bigtreetech/KNOMI/KNOMI_GIF/gif_probing/gif_probing.gif

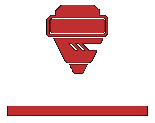
KNOMI_GIF/gif_probing/gif_probing.gif
