bigtreetech/KNOMI/Customized Printed Parts/Mounting Plate & StealthBurner Main Body for KNOMI.STL

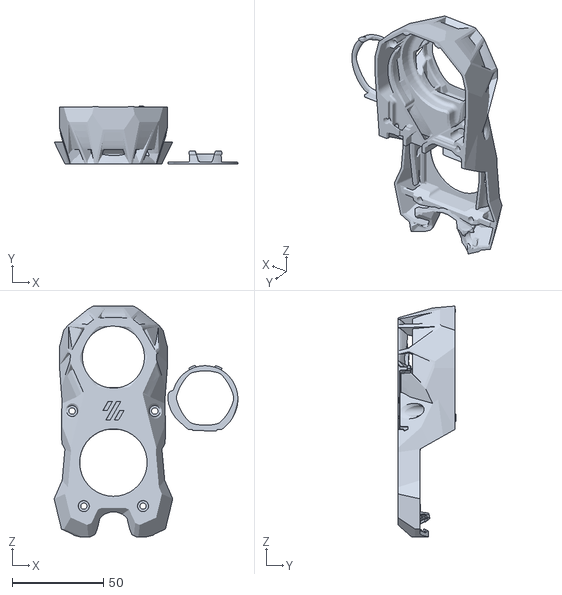
[picture p4: CAD file, 2023-04-26]
Customized Printed Parts/Mounting Plate & StealthBurner Main Body for KNOMI.STL
100.9 x 31.8 x 126.8
