bigtreetech/KNOMI/KNOMI1/Customized Printed Parts/StealthBurner Main Body for KNOMI.STL

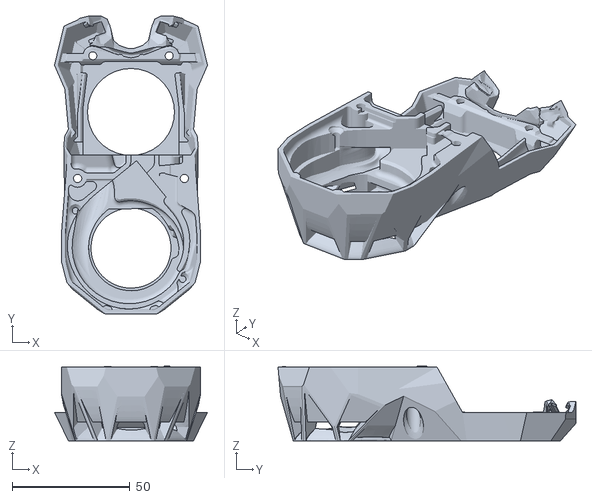
[picture p5: CAD file, 2023-06-05]
KNOMI1/Customized Printed Parts/StealthBurner Main Body for KNOMI.STL
65.1 x 126.8 x 31.8
