bigtreetech/KNOMI/KNOMI1/Customized Printed Parts/StealthBurner Mounting Plate for KNOMI.STL

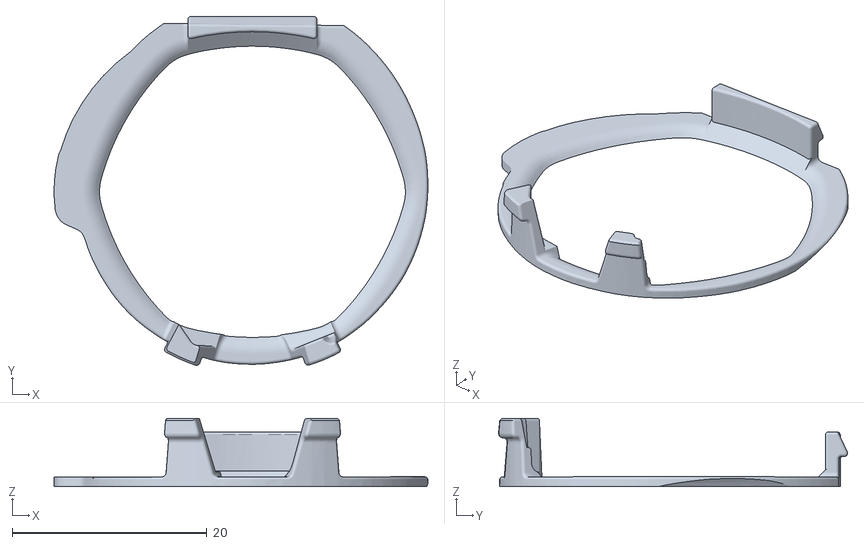
[picture p6: CAD file, 2023-06-05]
KNOMI1/Customized Printed Parts/StealthBurner Mounting Plate for KNOMI.STL
38.4 x 35.8 x 7.00
