bigtreetech/KNOMI/KNOMI2/CAD/KNOMI 2 Mounting Plate固定卡环V2.0.STEP

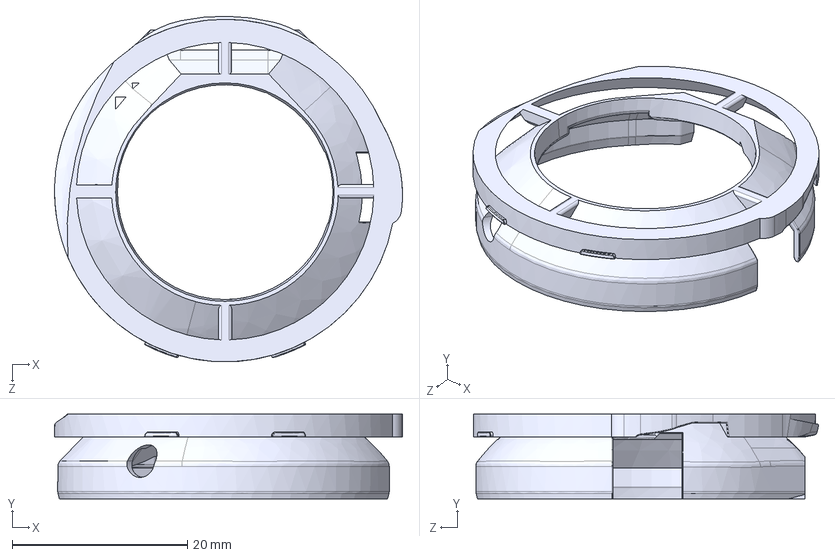
[picture p7: CAD file, 2024-03-30]
KNOMI2/CAD/KNOMI 2 Mounting Plate固定卡环V2.0.STEP
39.7 x 9.63 x 39.4 mm
