bigtreetech/KNOMI/KNOMI2/STL/KNOMI 2 Mounting Plate固定卡环.stl

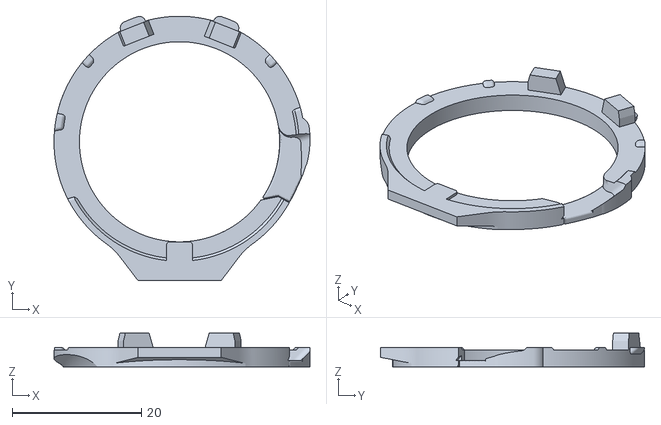
[picture p8: CAD file, 2023-11-15, an earlier design]
KNOMI2/STL/KNOMI 2 Mounting Plate固定卡环.stl
39.7 x 41.0 x 5.20
