bigtreetech/KNOMI/(list of files, cad)

Other CAD files:
KNOMI2/STL/KNOMI 2 Mounting Plate固定卡环V2.0.stl
