bigtreetech/KNOMI/KNOMI_GIF/gif_print/gif_print.gif

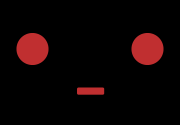
KNOMI_GIF/gif_print/gif_print.gif
