bigtreetech/KNOMI/(threads)

Thread 1 (2023-05-03):

Konomi PC duct section too thin.

Dr-Info, 2023-05-03:
Part has a section with a lack of material for printing with voron print specs, .2mm layer height. I checked the STL and even exported the STL from the CAD, both have the same issue.

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

bigtreetech, 2023-05-05:
Fixed in https://github.com/bigtreetech/KNOMI/commit/eafe51ef290f9e47f16155080b72e3c8a89418d7

Closed 2023-05-05.

Thread 2 (2023-05-07):

Macros on PDF do not format Correctly and getting `Macro G28 called recursively` homing errors from provided macros

BoothyBoothy, 2023-05-07:
Hi BTT
1. Copying the PDF macro content directly from the PDF does not work because all formatting content is lost and Klipper fails to boot due to parsing errors. The gcode lines need indenting to stop the parsing issue.
2. After including the Knomi Macros Print_Start fails with a repeated homing error stating `Macro G28 called recursively` (3 times).

Please advise and thanks Boothy

hdragoon, 2023-05-08:
You may did something wrong, as I did the same as instruction and no problem at all.

BoothyBoothy, 2023-05-08:
Thanks for the response. Hmmm, are you using a Klicky Probe or Tap? May be the external Klicky variable causing the issues? I doubt if my install will last long anyway, the PFC is less for it, great fun but not at the cost of print quality IMHO.

BoothyBoothy, 2023-05-08:
Further to my last comment. I use a Klicky Probe on my V2. If  I exclude the Klicky Variables.cfg the BTT homing macro works without errors and I get a House symbol on the Knomi display whilst homing, not tried anything else yet. The BTT macro therefore seems to work but does not allow for any external homing Macro reference like Klicky external Macros. I will need to consider what is the most tidy way forward with this and the Klicky. Thanks Boothy

dirkgo, 2023-05-09:
Same here. Also with Klicky Probe. Will figure out later today, how to fix it.

Surion79, 2023-05-17:
@BoothyBoothy I created a Pull Request to fix the G28 issue by using a dedicated `_KNOMI_STATUS` macro

Cyondil, 2023-05-18:
> @BoothyBoothy I created a Pull Request to fix the G28 issue by using a dedicated `_KNOMI_STATUS` macro

I have the Knomi and tested your PR and it doesn't seem to work at all.  If I use the lines above pointing to BED_MESH_CALIBRATE, the Knomi accurately shows levelling.  When I substitute in _KNOMI_STATUS, it doesn't work.  So seems like the logic is looking for the combination for the variable of the probing variable change and the BED_MESH_CALIBRATE combination.

Cyondil, 2023-05-18:
Had a whole thing typed up with a fix for homing this, but realized that while testing, my individual axis homing broke, so I am not confident enough to offer it as a fix.

Bazeone, 2023-06-06:
The changes worked for me.

sgermain06, 2023-07-02:
Yeah, I took a similar approach and added a `CUSTOM_HOMING` macro that the code is listening for, but it doesn't feel right. There has to be a better way to do this.

PeterGarthAmos, 2023-07-13:
Hi, all, I'm not that clued up with the code, please could you explain what you did exactly if you don't mind. (dumb it down) I have the same issue and have not been able to resolve it. I have klicky. the knomi macro causes Macro G28 called recursively.

3DMat, 2023-07-19:
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

hello sorry can you put a screen of the macro for homing if it's possible I'm trying the thousand recommended methods including using the _knomi_status updating the knomi with vcore and the bed mesh doesn't even work (only works using the one posted here)
A thousand thanks

silentstorm21, 2023-10-01:
i'm having this issue now

BoothyBoothy, 2023-10-01:
I found this to work well on my Minion Bed Slinger with Klicky.
https://github.com/bigtreetech/KNOMI/pull/5
The only thing that does not appear to work is the print finished macro? I have no problems with anything else.
Best Boothy

nephilim667, 2023-10-26:
Hello, i have integrated a knomi on my Creality K1. As i have issues to modify Knomi firmware, i have found solution to make it works with sandard firmware.
You can found details of macros modifications here :
https://github.com/D3vil-Design/K1-Hardware-Mods/issues/4#issue-1962019105

Thread 3 (2023-05-10):

Newest STL does not include the mounting plate

Cyondil, 2023-05-10:
The file only contains the Stealthburner cover, no mounting plate.

neriux912, 2023-05-10:
It is in step file, but not in stl

neriux912, 2023-05-10:
> The file only contains the Stealthburner cover, no mounting plate.

https://github.com/neriux912/KNOMI/blob/master/Customized%20Printed%20Parts/Mounting%20Plate.stl

Cyondil, 2023-05-15:
Looks like it was added after I looked.

Closed 2023-05-15.

Thread 4 (2023-05-13):

E3d Volcano?

el-quique, 2023-05-13:
Hello. Any chance for E3d Volcano? Thank you so much

hdragoon, 2023-05-14:
What does this have to do with e3d volcano hotend?

el-quique, 2023-05-15:
Hello. Thanks for answering. It is for use in an Artillery X1 printer. This printer uses the E3d Volcano, as its X axis uses a 2060 profile it needs the E3d volcano. There are some Stealthburner mods on thingiverse, but they have some bugs.

el-quique, 2023-05-16:
New change in the assembly design that I am designing, would give me the possibility of using a standard E3d v6. Maybe use a high flow nozzle. Thank you so much

Closed 2023-05-17.

Thread 6 (2023-05-17):

Animations have low fps after uploading Firmware

oMTEo, 2023-05-17:
As the title says after I uploaded compiled code via VSCode to a Knomi the animated Voronlogo/Emotes have very bad low fps. Maybe there are some settings missing in the firmware.

oMTEo, 2023-05-17:
It works now, Ive forgot to use this platform package -> https://github.com/z1996xm/arduino-esp32

Surion79, 2023-05-17:
@oMTEo can you please close this issue since it is no longer an issue? Thanks :)

oMTEo, 2023-05-17:
Done :)

Closed 2023-05-17.

Thread 7 (2023-05-18):

Homing certain axis homes all

neriux912, 2023-05-18:
Homing only one axis, homes all of them. Not work either clicking in Webui or issuing command in console

Surion79, 2023-05-20:
I hope the PR I created comes through. Then this is no longer an issue

neriux912, 2023-05-20:
> I hope the PR I created comes through. Then this is no longer an issue

is there any clear instructions online, how to recompile firmware?

SrgntBallistic, 2023-05-29:
> how to recompile firmware?

https://bigtreetech.github.io/docs/KNOMI.html#customize-ui

Outlined here. Setup VS Code with platformIO. Connect via USB-C -> verify/compile and upload

Closed 2023-05-29.

Thread 8 (2023-05-20):

Mounting plate?

appleimperio, 2023-05-20:
Where is the sty for the mounting plate?

neriux912, 2023-05-20:
> Where is the sty for the mounting plate?

https://github.com/neriux912/KNOMI/blob/master/Customized%20Printed%20Parts/Mounting%20Plate.stl

appleimperio, 2023-05-20:
Is the same? why is not in the Bigtreetech GitHub?

neriux912, 2023-05-20:
> Is the same? why is not in the Bigtreetech GitHub?

it's pulled out from step file

appleimperio, 2023-05-20:
ok Thanks

Closed 2023-05-20.

Thread 9 (2023-05-21):

Mounting plate missing from STL.

grimlokason, 2023-05-21:
Hello,

The mounting plate is not anymore in the STL here :

https://github.com/bigtreetech/KNOMI/blob/master/Customized%20Printed%20Parts/Mounting%20Plate%20%26%20StealthBurner%20Main%20Body%20for%20KNOMI.STL

zcohenld, 2023-05-22:
They just updated it with the mounting plate, but be aware, they uploaded the two parts as one file and most importantly the mounting plate is not flat on the build plate. So break it into two parts and use the place on face tool in your slicer to lay the plate flat.

thisiskeithb, 2023-05-23:
Here's a zip with the KNOMI StealthBurner & separated mounting plate properly aligned: [Mounting Plate & StealthBurner Main Body for KNOMI.STL.zip](https://github.com/bigtreetech/KNOMI/files/11543902/Mounting.Plate.StealthBurner.Main.Body.for.KNOMI.STL.zip)

chromusphil, 2023-05-31:
The new version was rushed and the plate isn't sitting flat, please provide separate STLs and or FIX the plate so its laying flat on the bed.

grimlokason, 2023-06-04:
@bigtreetech is it possible to accept the pull request ?

Thank you.

Closed 2023-06-06.

Thread 11 (2023-05-31):

Failed to connect to ESP32: No serial data received

Guilouz, 2023-05-31:
It's impossible for me to flash Knomi. I have tested on MacOS and Windows, same issue.

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

Serial Console detect Knomi but impossible to flash it :

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

oMTEo, 2023-05-31:
To upload Firmware to Knomi follow these steps :
-Remove Knomi from USB-Port.
-Push Upload in VSCode and wait till "Connecting....."
-Hold down the Boot-Button on Knomi, plug it back to the USB-Port and release Boot-Button.

Closed 2023-05-31.

Thread 14 (2023-06-06):

Printing percentages not correct

Nelus82, 2023-06-06:
Mainsail and klipperscreen gives a lower percentage of the print than KNOMI.

chromusphil, 2023-08-05:
I’ve experienced this however I did notice that the % matched that displayed in the 12864 screen on my v2.4 so I’m assuming the completeness used by Mainsail/Klipperscreen is calculated differently to the Knomi/12864

chromusphil, 2023-08-06:
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
Further to my reply above

Mcrcheli, 2023-08-31:
Seems to calculate the percentage from the time you press print. As you get into the print the percentage converge and I have seen the numbers match in the 75-80 range.

nephilim667, 2023-10-26:
Hello, i hvae found something relative to this.
Knomi use the Display_Status Api function of Klipper.
As you can see, Display status use value from M73 if GCode containt it :
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

As i have the same issue, i have tried to disable 'Support remaining time' is prusaslicer to avoid emmiting M73 in GCode.
Seem to work. Now Knomi show the same value as i have on my K1 Screen and on Fluidd

Thread 15 (2023-06-29):

KNOMI screen turns off

aee74, 2023-06-29:
Hi, My KNOMI screen just turns off. Sometimes it won't even startup (You can see it's powerd because screen lights up) and other times it starts and half way a print it turns blank.  I tried using different voltages to power the KNOMI everytime the same thing.  Any suggestions?

fsedarkalex, 2025-07-31:
OH! I answered it myself... It does not boot when the camera is not connected

Thread 16 (2023-07-02):

Is there a way for Knomi to show temp by Tool?

TheSin-, 2023-07-02:
I'd like to add a knot to each of my tools and show the temp of the tool it's attached to, is there a way to accomplish this easily?  To T0 will show the temp for T0 and T1 will show the temp for T1 etc etc

M4dMike, 2023-08-10:
Sounds like a cool idea :)

This would require costume code on each Knomi, but can definitely be achieved.

Have a look at line 1007 to 1015 in [main.cpp](https://github.com/bigtreetech/KNOMI/blob/master/Firmware/src/main.cpp)

    String nameStr3 = doc["temperature"]["tool0"]["actual"].as<String>();
    String nameStr4 = doc["temperature"]["tool0"]["target"].as<String>();
    String nameStr5 = doc["state"]["flags"]["printing"].as<String>();
    String nameStr6 = doc["state"]["flags"]["paused"].as<String>();

    bedtemp_actual = (uint16_t)((doc["temperature"]["bed"]["actual"].as<double>())*100);
    bedtemp_target = (uint16_t)((doc["temperature"]["bed"]["target"].as<double>())*100);
    tooltemp_actual = (uint16_t)((doc["temperature"]["tool0"]["actual"].as<double>())*100);
    tooltemp_target = (uint16_t)((doc["temperature"]["tool0"]["target"].as<double>())*100);`

As you can see, its referencing temps for `tool0` -> change that too `tool1` and build + flash it to your second KNOMI

TheSin-, 2023-08-10:
excellent!  I'll order up an other one to see if I can figure it out, this will be great if I can get it running!

TheSin-, 2023-08-10:
Do you know of an example to make it a configuration option on startup, like the screen used for the wifi setup?  That way they can all have one firmware that I can just select the tool id on?

Trying to figure out the codebase for configuration options.

M4dMike, 2023-08-10:
Exactly, adding a 4th input field and storing this information makes it dynamic and would probably help to get this change back into mainline. Awesome!

TheSin-, 2023-08-11:
Into the testing phase now!  Thanks again for leading me into the right direction, I'm going to make a PR once I know 100% it's working and saving.

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

M4dMike, 2023-08-11:
Awesome 😀
Happy to help, knomi has a lot of unused potential 😉

mcbeenb, 2023-11-20:
Awesome work guys!!

Thread 18 (2023-08-01):

2 KNOMI's will not power on by USB-C connection to computer or show up in device list

sprior, 2023-08-01:
I've got 2 KNOMI's which show no signs of power when connected via USB-C to either of two Win 11 laptops (and don't know up as ports in device manager, but do power up when connected via USB-C wall wart.  The problem is that I'm looking to customize their firmware and see no way to do that.  I have other ESP32 devices with power up and flash just fine from my laptop.

I've otherwise got a VS Code dev environment set up just fine for ESP32 devices on this laptop so I'm pretty stumped why the KNOMI's aren't working.  Any ideas?

M4dMike, 2023-08-08:
Had the same issue, USB-A to USB-C works for me, Knomi is showing up in device manager as "USB-SERIAL CH340 (COM3)"

Did you manage to get to a working state? I am struggling with flashing, as uploading the firmware fails...

> A fatal error occurred: Failed to connect to ESP32: No serial data received.

Malygros, 2023-08-10:
> I was using a USB-C to USB-C cable to plug them into my computer. By any chance is a USB-A (computer) to USB-C (KNOMI) cable required to make it work?

Did you mange do get it work? Got the same error. Even with USB-A to USB-C.
USB-SERIAL CH340 (COM4) is recognized in the device Manager.

sprior, 2023-08-10:
It's been working for me with a USB-C to USB-A cable, though the requirement to use one isn't documented anywhere that I've seen.  I also have to hold the boot button before plugging it in, then it's recognized by the flash utility in PlatformIO.

Fragmon, 2023-08-10:
Is this possible that knomi make a Mistake with tracing? They add a 10k on 3.3V not gnd
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

M4dMike, 2023-08-10:
Nope, it's correct and it works fine after all.
If you want to set it into boot mode, disconnect it from power, press the button an plug it in while the button is pressed

sprior, 2023-08-10:
@M4dMike Flash mode only works with a USB-A to USB-C cable for me when connecting to my laptop.  If I use a USB-C to USB-C cable the KNOMI doesn't get power at all when in boot mode or not.  That same USB-C to USB-C cable works with a USB-C power supply.

M4dMike, 2023-08-10:
Same for me.

Fragmon, 2023-08-10:
> @Fragmon Nope, it's correct and it works fine after all. If you want to set it into boot mode, disconnect it from power, press the button an plug it in while the button is pressed

I know this:) but it dont change the Mode. It's always in serial.

sprior, 2023-08-10:
@M4dMike I am not at all an expert on this, but I think I've heard that USB-C devices use resistors to signal their need for power or ability to provide it.  So I thought @Fragmon's comment about resistors not being correct might be related to power delivery and not the ability to enter boot mode.  It could also explain why a USB-A to USB-C cable would work and a USB-C to USB-C does not.

Ybalrid, 2023-09-10:
all I know is that the modem control signals from the serial are not able to reset the device from the USB port. You need to press the boot button to upload new firmware, and once new firmware is uploaded, you need to disconnect and reconnect the device for it to startup again.

Thread 19 (2023-08-07):

Failed to connect to ESP32: No serial data received.

ThomasDennisSp, 2023-08-07:
I tryed the methode that the other person had and others tryed but they had no effect i cant get vs to flash firmware to my knomi it gets detected and everything by vs but the flashing will not work

M4dMike, 2023-08-08:
Get the exact same error.

>Configuring upload protocol...
AVAILABLE: cmsis-dap, esp-bridge, esp-prog, espota, esptool, iot-bus-jtag, jlink, minimodule, olimex-arm-usb-ocd, olimex-arm-usb-ocd-h, olimex-arm-usb-tiny-h, olimex-jtag-tiny, tumpa
CURRENT: upload_protocol = esptool
Looking for upload port...
Auto-detected: COM3
Uploading .pio\build\esp32dev\firmware.bin
esptool.py v4.5.1
Serial port COM3
Connecting......................................
> A fatal error occurred: Failed to connect to ESP32: No serial data received.
For troubleshooting steps visit: https://docs.espressif.com/projects/esptool/en/latest/troubleshooting.html

COM3 is detected as USB-Serial CH340

M4dMike, 2023-08-08:
After reading the documentation on the ESP32 i got it working:

1. Build image
2. Press Boot button while plugging the KNOMI into the USB Port
3. Upload Image

ThomasDennisSp, 2023-08-08:
ok the comment above helped me in figuring it out it is important that your knomi is not getting pover over the jst then
1. build image
2. press and keep holding the boot button for the complete time it takes
3. connect the usb-c to your pc (still holding the button)
4. upload image (still holding button till success massage comes up)
5. let the boot button go unplug usb c
6. connect it to your printer
7. profit

Closed 2023-08-08.

Thread 22 (2023-08-22):

Icons working correctly with TAP

Mcrcheli, 2023-08-22:
Config from the manual added them corrected because it did not copy and paste correctly. Homing icon works correctly. While Gantry level the homeing Icon displays. While mesh bed leveling the home icon displays. After the bed met completes, the screen status icon displays 2% while the heater heats to temperature and I receive a message in Klipper "SET_GODE not valid command". Then as the print starts the screen displays 3% and increases as print progresses.  Hopefully when this issue is solved the it will work with KAMP bedd mesh leveling.

Thread 23 (2023-08-24):

Knomi only shows standby GIF

bthubs, 2023-08-24:
I cannot for the life of me get Knomi to work properly. Knomi is able to connect to my printer but it just stays on standby mode most of the time. The only thing I've been able to get working is homing after adding macro [_KNOMI_STATUS](https://github.com/bigtreetech/KNOMI/pull/5) per user Surio79 and flashing it per Cyanodil's [post](https://github.com/bigtreetech/KNOMI/pull/5#pullrequestreview-1435418111) on the same thread. Probing is supposed to work with this macro but it doesn't for me. This is all on a Micron+. I rebooted the Knomi to work with my v2.4 and it works perfectly fine there, which is strange because I built the Micron+ using the same config files I used on the v2.4. I suspect it is a moonraker problem. Not sure this is related but for some reason, in fluidd, under the print jobs, there's no data listed for "Last printed" even though I've printed files before. This data does appear on my v2.4. Additionally, I've tried reflashing my CB1 with fresh version of klipper, as well as change my motherboard from manta m8p + cb1 to octopus max ez + pad7. Even tried a cb1 emmc with fresh klipper. Still no luck.  After these changes, I still don't get any information under "Last printed". I've spent days trying to figure this out, I have 3 Knomis, none of which can connect to my Micron+, all of which can connect to my v2.4. I'm about to try a completely customized UI but I'd thought I'd try my luck here before doing that.

Any bright minds out there have any idea wtf is going on?

bthubs, 2023-08-30:
Got it to work. I'm not completely sure this is the issue but it seems to be a problem with the "minimal" cb1 version. When I would do [printer ip]/api/printer with the minimal version, I got error 404. On my v2.4 this was not an issue (it would provide printer information). After installing the full cb1 version (v2.3.3) for the Micron+, I was able to get printer info. It may have to do with the minimal version of cb1 and how it installs moonraker.

Anyway, closing this issue.

Closed 2023-08-30.

Thread 24 (2023-08-30):

Esp32-C3 mini 1U

Moby96669, 2023-08-30:
Is it possible to install on ESP32-C3-Mini-1U?

DrKlipper, 2023-10-04:
Hi !
Just ported it to an Esp32-C3 mini 1U.
I will create a fork on github and paste my results.

Moby96669, 2023-10-11:
Does not compile in Arduino, errors appear. I compile in VS, upload, but it doesn't work, the screen doesn't turn on. Maybe l'm doing something wrong? Help please

Thread 25 (2023-09-07):

KAMP bed mesh level now disabled

Mcrcheli, 2023-09-07:
After finally getting the knomi to work as intended, my last issue is that the code disables KAMP. KAMP renames bed_mesh_calibrate to _bed_mesh_calibrate. Wondering if knomi  renaming it to bed_mesh_calibrate_base is the issue. The Kamp.cfg is read only so not sure what to look at. Thanks!

Ybalrid, 2023-09-09:
Having the same issue right now! I may just set the gcode variables on my own around my leveling stuff in PRINT_START instead see if it can trigger the animation without breaking KAMP

Mcrcheli, 2023-09-09:
I commented out the mesh leveling lines of code. This allows Kamp to wrk but the icon doesn’t work. I have an email into BTT and found my original issue but they are working on the Kamp issue. When I get the reply I will post it here.

Ybalrid, 2023-09-09:
I have done a hack in the mean time, sadly it requires KNOMI firmware modification

I now set the `variable_probing` inside `PRINT_START` around my bed mesh (and quad gantry) leveling calls. But for KNOMI to fetch the state, you need to replace what gcode_macro is looked at in the API response from Moonraker in a few places in `main.cpp`. Not ideal

Ybalrid, 2023-09-10:
@Mcrcheli if you do not mind a hacky solution: This is the patch to the KNOMI firmware to make it look for that "probing" gcode variable into PRINT_START https://github.com/Ybalrid/KNOMI-UNIT-01/commit/9f0720a12bec801c4792ece9430cd3b0d4f2c912

This is how it is used:
```ini
[gcode_macro PRINT_START] #   Use PRINT_START for the slicer starting script - please customise for your slicer of choice
variable_probing:False
gcode:
    # ...
    SET_GCODE_VARIABLE MACRO=PRINT_START VARIABLE=probing VALUE=True
    # Do your meshing and your leveling and all that stuff
    SET_GCODE_VARIABLE MACRO=PRINT_START VARIABLE=probing VALUE=False
```

nephilim667, 2023-10-26:
Hello, i have integrated a knomi on my Creality K1. As i have issues to modify Knomi firmware, i have found solution to make it works with sandard firmware.
You can found details of macros modifications here :
https://github.com/D3vil-Design/K1-Hardware-Mods/issues/4#issue-1962019105

Ybalrid, 2024-01-18:
@Sidkrsk in your slicer, you may want to add something like this to your layer change custom code

```gcode
;[layer_z]
M73 P{(layer_num*100)/total_layer_count}
```

This will insert a GCODE command `M73 PX` where X is the percentage completion of the model, computed from the height (you may be able to do this with the time estimate, but that sounds more complicated to do)

The above is using **Prusa Slicer** templating syntax. For other slicers, you may need to do something different.

Sidkrsk, 2024-01-19:
I still managed to add it to KAMP. I used the latest firmware from December 14th.

printer.cfg

```
[gcode_macro _KNOMI_STATUS]
variable_homing: False
variable_probing: False
variable_qgling: False
variable_heating_nozzle: False
variable_heating_bed: False
gcode:

[gcode_macro M109]
rename_existing: M109.1
gcode:
  SET_GCODE_VARIABLE MACRO=_KNOMI_STATUS VARIABLE=heating_nozzle VALUE=True
  M109.1 {rawparams}
  SET_GCODE_VARIABLE MACRO=_KNOMI_STATUS VARIABLE=heating_nozzle VALUE=False

[gcode_macro M190]
rename_existing: M190.1
gcode:
  SET_GCODE_VARIABLE MACRO=_KNOMI_STATUS VARIABLE=heating_bed VALUE=True
  M190.1 {rawparams}
  SET_GCODE_VARIABLE MACRO=_KNOMI_STATUS VARIABLE=heating_bed VALUE=False

[gcode_macro G28]
rename_existing: G28.1
gcode:
  SET_GCODE_VARIABLE MACRO=_KNOMI_STATUS VARIABLE=homing VALUE=True
  G28.1 {rawparams}
  SET_GCODE_VARIABLE MACRO=_KNOMI_STATUS VARIABLE=homing VALUE=False

#[gcode_macro BED_MESH_CALIBRATE]
#rename_existing: BTT_BED_MESH_CALIBRATE
#gcode:
#  SET_GCODE_VARIABLE MACRO=_KNOMI_STATUS VARIABLE=probing VALUE=True
#  BTT_BED_MESH_CALIBRATE
#  SET_GCODE_VARIABLE MACRO=_KNOMI_STATUS VARIABLE=probing VALUE=False

# For printer with QGL
[gcode_macro QUAD_GANTRY_LEVEL]
rename_existing: BTT_QUAD_GANTRY_LEVEL
gcode:
  SET_GCODE_VARIABLE MACRO=_KNOMI_STATUS VARIABLE=qgling VALUE=True
  BTT_QUAD_GANTRY_LEVEL
  SET_GCODE_VARIABLE MACRO=_KNOMI_STATUS VARIABLE=qgling VALUE=False
```

Adaptive_Mesh.cfg

```
[gcode_macro BED_MESH_CALIBRATE]
rename_existing: _BED_MESH_CALIBRATE
gcode:

    {% set all_points = printer.exclude_object.objects | map(attribute='polygon') | sum(start=[]) %}                                # Gather all object points
    {% set bed_mesh_min = printer.configfile.settings.bed_mesh.mesh_min %}                                                          # Get bed mesh min from printer.cfg
    {% set bed_mesh_max = printer.configfile.settings.bed_mesh.mesh_max %}                                                          # Get bed mesh max from printer.cfg
    {% set probe_count = printer.configfile.settings.bed_mesh.probe_count %}                                                        # Get probe count from printer.cfg
    {% set kamp_settings = printer["gcode_macro _KAMP_Settings"] %}                                                                 # Pull variables from _KAMP_Settings
    {% set verbose_enable = kamp_settings.verbose_enable | abs %}                                                                   # Pull verbose setting from _KAMP_Settings
    {% set probe_dock_enable = kamp_settings.probe_dock_enable | abs %}                                                             # Pull probe dockable probe settings from _KAMP_Settings
    {% set attach_macro = kamp_settings.attach_macro | string %}                                                                    # Pull attach probe command from _KAMP_Settings
    {% set detach_macro = kamp_settings.detach_macro | string %}                                                                    # Pull detach probe command from _KAMP_Settings
    {% set mesh_margin = kamp_settings.mesh_margin | float %}                                                                       # Pull mesh margin setting from _KAMP_Settings
    {% set fuzz_amount = kamp_settings.fuzz_amount | float %}                                                                       # Pull fuzz amount setting from _KAMP_Settings
    {% set probe_count = probe_count if probe_count|length > 1 else probe_count * 2  %}                                             # If probe count is only a single number, convert it to 2. E.g. probe_count:7 = 7,7
    {% set max_probe_point_distance_x = ( bed_mesh_max[0] - bed_mesh_min[0] ) / (probe_count[0] - 1)  %}                            # Determine max probe point distance
    {% set max_probe_point_distance_y = ( bed_mesh_max[1] - bed_mesh_min[1] ) / (probe_count[1] - 1)  %}                            # Determine max probe point distance
    {% set x_min = all_points | map(attribute=0) | min | default(bed_mesh_min[0]) %}                                                # Set x_min from smallest object x point
    {% set y_min = all_points | map(attribute=1) | min | default(bed_mesh_min[1]) %}                                                # Set y_min from smallest object y point
    {% set x_max = all_points | map(attribute=0) | max | default(bed_mesh_max[0]) %}                                                # Set x_max from largest object x point
    {% set y_max = all_points | map(attribute=1) | max | default(bed_mesh_max[1]) %}                                                # Set y_max from largest object y point

    {% set fuzz_range = range((0) | int, (fuzz_amount * 100) | int + 1) %}                                                          # Set fuzz_range between 0 and fuzz_amount
    {% set adapted_x_min = x_min - mesh_margin - (fuzz_range | random / 100.0) %}                                                   # Adapt x_min to margin and fuzz constraints
    {% set adapted_y_min = y_min - mesh_margin - (fuzz_range | random / 100.0) %}                                                   # Adapt y_min to margin and fuzz constraints
    {% set adapted_x_max = x_max + mesh_margin + (fuzz_range | random / 100.0) %}                                                   # Adapt x_max to margin and fuzz constraints
    {% set adapted_y_max = y_max + mesh_margin + (fuzz_range | random / 100.0) %}                                                   # Adapt y_max to margin and fuzz constraints

    {% set adapted_x_min = [adapted_x_min , bed_mesh_min[0]] | max %}                                                               # Compare adjustments to defaults and choose max
    {% set adapted_y_min = [adapted_y_min , bed_mesh_min[1]] | max %}                                                               # Compare adjustments to defaults and choose max
    {% set adapted_x_max = [adapted_x_max , bed_mesh_max[0]] | min %}                                                               # Compare adjustments to defaults and choose min
    {% set adapted_y_max = [adapted_y_max , bed_mesh_max[1]] | min %}                                                               # Compare adjustments to defaults and choose min

    {% set points_x = (((adapted_x_max - adapted_x_min) / max_probe_point_distance_x) | round(method='ceil') | int) + 1 %}          # Define probe_count's x point count and round up
    {% set points_y = (((adapted_y_max - adapted_y_min) / max_probe_point_distance_y) | round(method='ceil') | int) + 1 %}          # Define probe_count's y point count and round up

    {% if (([points_x, points_y]|max) > 6) %}                                                                                       #
        {% set algorithm = "bicubic" %}                                                                                             #
        {% set min_points = 4 %}                                                                                                    #
    {% else %}                                                                                                                      # Calculate if algorithm should be bicubic or lagrange
        {% set algorithm = "lagrange" %}                                                                                            #
        {% set min_points = 3 %}                                                                                                    #
    {% endif %}                                                                                                                     #

    {% set points_x = [points_x , min_points]|max %}                                                                                # Set probe_count's x points to fit the calculated algorithm
    {% set points_y = [points_y , min_points]|max %}                                                                                # Set probe_count's y points to fit the calculated algorithm
    {% set points_x = [points_x , probe_count[0]]|min %}
    {% set points_y = [points_y , probe_count[1]]|min %}

    {% if verbose_enable == True %}                                                                                                 # If verbose is enabled, print information about KAMP's calculations
        {% if printer.exclude_object.objects != [] %}

            { action_respond_info( "Algorithm: {}.".format(                                                                      
                (algorithm),                                                                                                    
            )) }

            { action_respond_info("Default probe count: {},{}.".format(                                                          
                (probe_count[0]),                                                                                               
                (probe_count[1]),                                                                                               
            )) }

            { action_respond_info("Adapted probe count: {},{}.".format(                                                          
                (points_x),                                                                                                     
                (points_y),                                                                                                     
            )) }                                                                                                      

            {action_respond_info("Default mesh bounds: {}, {}.".format(                                                          
                (bed_mesh_min[0],bed_mesh_min[1]),                                                                              
                (bed_mesh_max[0],bed_mesh_max[1]),                                                                              
            )) }

            {% if mesh_margin > 0 %}                                                                                            
                {action_respond_info("Mesh margin is {}, mesh bounds extended by {}mm.".format(                               
                    (mesh_margin),                                                                                              
                    (mesh_margin),                                                                               
                )) }                                                                                                            
            {% else %}                                                                                                          
                {action_respond_info("Mesh margin is 0, margin not increased.")}                                                
            {% endif %}                                                                                                         

            {% if fuzz_amount > 0 %}                                                                                            
                {action_respond_info("Mesh point fuzzing enabled, points fuzzed up to {}mm.".format(                             
                    (fuzz_amount),                                                                                              
                )) }                                                                                                            
            {% else %}                                                                                                          
                {action_respond_info("Fuzz amount is 0, mesh points not fuzzed.")}                                              
            {% endif %}                                                                                                         

            { action_respond_info("Adapted mesh bounds: {}, {}.".format(                                                         
                (adapted_x_min, adapted_y_min),                                                                                 
                (adapted_x_max, adapted_y_max),                                                                                 
            )) }

            {action_respond_info("KAMP adjustments successful. Happy KAMPing!")}

        {% else %}

            {action_respond_info("No objects detected! Check your gcode and make sure that EXCLUDE_OBJECT_DEFINE is happening before BED_MESH_CALIBRATE is called. Defaulting to regular meshing.")}
            G4 P5000                                                                                                                # Wait 5 seconds to make error more visible
        {% endif %}

    {% endif %}

    {% if probe_dock_enable == True %}
        {attach_macro}                                                                                                              # Attach/deploy a probe if the probe is stored somewhere outside of the print area
    {% endif %}

    SET_GCODE_VARIABLE MACRO=_KNOMI_STATUS VARIABLE=probing VALUE=True
    _BED_MESH_CALIBRATE mesh_min={adapted_x_min},{adapted_y_min} mesh_max={adapted_x_max},{adapted_y_max} ALGORITHM={algorithm} PROBE_COUNT={points_x},{points_y}
    SET_GCODE_VARIABLE MACRO=_KNOMI_STATUS VARIABLE=probing VALUE=False

    {% if probe_dock_enable == True %}
        {detach_macro}                                                                                                              # Detach/stow a probe if the probe is stored somewhere outside of the print area
    {% endif %}                                                                                                                     # End of verbose

```

FxWoody, 2025-02-25:
To use KAMP, simply change KNOMI.cfg like so .... works on my Qidi Plus 4
`[gcode_macro _BED_MESH_CALIBRATE]
rename_existing: BTT_BED_MESH_CALIBRATE
gcode:
  SET_GCODE_VARIABLE MACRO=_KNOMI_STATUS VARIABLE=probing VALUE=True
  BTT_BED_MESH_CALIBRATE {rawparams}
  SET_GCODE_VARIABLE MACRO=_KNOMI_STATUS VARIABLE=probing VALUE=False`

Thread 27 (2023-09-14):

Knomi: additional Homing / and Wifi setup procedure every time if printer is restarted

Casy11, 2023-09-14:
Hello everyone,

I'm new to the Voron community and now have a Trident with TAP. The Knomi is also new and installed successfully. Unfortunately I'm having two problems with the Knomi and I would be happy if someone could help me.

1.
When I turn on the printer, the Knomi does not reconnect to the WiFi. Every time I have to press the boot button for 5 seconds and re-establish the connection. Then it runs until the next restart. Can anyone say what that could be?

2.
After I inserted the "Knomi gecode macro" into the printer.cfg, additional homing is carried out. This happens at the beginning of the print job (it's normal) and the second time between "calibrating_z" and "BED_MESH_CALIBRATE". I think it has something to do with the G28 in the macro. Is anyone able to help me?

Thanks in advance!

Casy11, 2023-09-20:
It's Close:
1: Please look at comment from BHoggs #28
2: it takes sometimes up to 15min, sometimes less to recognize the network, but than it works.

Closed 2023-09-20.

Thread 28 (2023-09-17):

Macros should pass on all parameters

BHoggs, 2023-09-17:
The macros included in the manual results in the commands ignoring any params given to them. For example, `G28 Z` should only home the Z axis, but will now always re-home all axes.

These updated macros should work better as it passes `{rawparams}` back to the base commands:

```ini
[gcode_macro BED_MESH_CALIBRATE]
rename_existing: BED_MESH_CALIBRATE_BASE
variable_probing:False

gcode:
  SET_GCODE_VARIABLE MACRO=BED_MESH_CALIBRATE VARIABLE=probing VALUE=True
  BED_MESH_CALIBRATE_BASE {rawparams}
  SET_GCODE_VARIABLE MACRO=BED_MESH_CALIBRATE VARIABLE=probing VALUE=False

[gcode_macro G28]
rename_existing: G0028
variable_homing:False

gcode:
  SET_GCODE_VARIABLE MACRO=G28 VARIABLE=homing VALUE=True
  G0028 {rawparams}
  SET_GCODE_VARIABLE MACRO=G28 VARIABLE=homing VALUE=False
```

Casy11, 2023-09-20:
Thanks a lot. This code is works well. The homing and afterwards bed mesh works like it should, without a second time homing.

Thread 29 (2023-09-27):

Doesn't power up on PD chargers / USB-C ports on Macbooks

ulope, 2023-09-27:
It's really annoying that the knomi doesn't properly implement USB-C.

It can't be powered by either PD compliant USB-C chargers (which pretty much all new ones are nowadays), nor when plugged into a Macbook with a straight USB-C <-> USB-C cable...

Kprobem, 2023-09-30:
(TYPE-C) CC <- 5.1K -> GND

mcbeenb, 2023-11-20:
I have also found using a usba ->usbc cable works fine.

ulope, 2023-11-20:
I'm aware that there are workarounds.

It doesn't change the fact that it's not easily usable with compliant supplies that will become pretty much the default going forward.

Thread 30 (2023-09-27):

G28 macro override does not preserve command arguments

Ybalrid, 2023-09-27:
## The bug

The G28 commands can take the axes to home as arguments.

The macro in the KNOMI documentation will not pass those arguments to the original macro as-is, and will instead transform any homing commands into a full printer homing command.

## How to test

Without using the KNOMI macros, run the following gcode from the console:

```gcode
G28 X
```
It only homes the X axis. If you install the KNOMI  macros, it will instead home the full printer.

## How to fix

To preserve the behavior prior to KNOMI installation, the macro needs to pass those arguments back to the original.

I propose to use [Klipper's `rawparams` feature](https://www.klipper3d.org/Command_Templates.html#the-rawparams-variable) to fix this thusly:

```ini
[gcode_macro G28]
rename_existing: G0028
variable_homing:False

gcode:
  SET_GCODE_VARIABLE MACRO=G28 VARIABLE=homing VALUE=True
  G0028 {rawparams}
  SET_GCODE_VARIABLE MACRO=G28 VARIABLE=homing VALUE=False
```

jace, 2024-08-06:
This doesn't work any more. Klipper complains "Macro G28 called recursively". What I tried:

```ini
[gcode_macro G28]
rename_existing: G00028
gcode:
    SET_GCODE_VARIABLE MACRO=_KNOMI_STATUS VARIABLE=homing VALUE=True
    G00028 {rawparams}
    SET_GCODE_VARIABLE MACRO=_KNOMI_STATUS VARIABLE=homing VALUE=False
```

I also tried the `homing_override` approach recommended elsewhere, but this version tries to home Z at `x_max, y_max` instead of the bed centre at `x_max/2, y_max/2`:

```ini
[homing_override]
gcode:
    SET_GCODE_VARIABLE MACRO=_KNOMI_STATUS VARIABLE=homing VALUE=True
    G28 {rawparams}
    SET_GCODE_VARIABLE MACRO=_KNOMI_STATUS VARIABLE=homing VALUE=False
```

Thread 31 (2023-10-14):

KNOMI GIF

CBoismenu, 2023-10-14:
Not a problem with KNOMI itself but a problem with the GIF file subblied by BigTreeTech.

The GIF for leveling in the ZIP file is not the same as the one used in the original firmware.

The one in the firmware is a hotend going up an down, the onr in the ZIP file is like the circles that would be created by throwing a rock in water.

I've searched and could not find the original leveling GIF used by BTT.

Would it be possible to get a copy of the original leveling GIF.

Thanks,

lvlacleod, 2023-10-14:
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

CBoismenu, 2023-10-14:
Thank's that was quick.

Closed 2023-10-17.

Thread 34 (2023-11-05):

Alternate Version for Rapido UHF?

brandonb86, 2023-11-05:
Would it be possible for an alternate "Main Body" file to be published for the Rapido UHF?  The official Stealthburner mod is located here: [https://mods.vorondesign.com/detail/XN1NolgVYYBu1HNnxqC7Fg](https://mods.vorondesign.com/detail/XN1NolgVYYBu1HNnxqC7Fg)

irgendwer92, 2023-11-23:
Someone made one on printables: https://www.printables.com/de/model/496608-kenny-mod-2-for-the-btt-knomi-display/files

Bazeone, 2024-01-03:
https://www.printables.com/model/472881-hex-stealthburner-knomi-3do-nozzle-camera-rapido-u

Thread 36 (2023-11-12):

Where is the repository for Knomi V2?

MKloberg, 2023-11-12:
I was working on bringing Knomi V1 into the ender world on top of the wildly successful Taurus cooling duct.
This was days from release when Knomi V2 suddenly came out.
To make an enclosure for V2, I will need more information so I'm looking for the open source repository that was advertised, but all links I can find still go to the V1 repo. Where is it?

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

MKloberg, 2023-11-18:
Found the firmware branch for V2, this issue can be closed. :-)

MKloberg, 2023-11-18:
Please see comment, all good now.

Closed 2023-11-18.

Thread 37 (2023-11-12):

Knomi V2: Doesn't retain WiFi information.

MKloberg, 2023-11-12:
When multiple networks are present, Knomi V2 onboarding works and connects to the specified network after 1st restart.
After 1st power cycle, it goes back to onboarding screen and we have to enter the WiFi password again. This repeats itself.
Each time this is done, a new network entry is added to the WiFi networks table.

If this is the wrong repository, please indicate where the correct one is for Knomi V2.

Rowan2233, 2023-11-15:
Hey bro, i am sorry to bring this experience for you. To make sure of this problem, we have this two questions, please help:
1. Did KNOMI 2 suddenly back to the "Hello" page when you repower ? Or it have the “LOGO+circle loading”page for a while and then it back to the "Hello” page？
2. Do you installed the antenna on KNOMI 2 during you  repower KNOMI 2?

MKloberg, 2023-11-15:
Hello, the antenna was installed the whole time. After power is applied, the Logo and circle page comes up, circles several times and then it goes into the Hello page. Someone else that I'm working with is seeing the exact same thing.

MKloberg, 2023-11-18:
Now that the firmware is available I was able to monitor the serial output of V2 and understand this a little better.
The normal onboarding looks like the monitor below, all good.
After the power is removed and plugged back in, it doesn't find that network again and goes back into setup mode.

A theory I have is that it finds multiple networks of the same name in my case, because I'm on a Google mesh network.
The multiple AP's I have, appear all with the same name in the list at the top of the setup screen.

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

Perhaps after reboot, it's connecting to the wrong access point (too far away), fails the check and pops back into setup mode.

Unfortunately, I can't simulate a cold boot up, because the serial port isn't available in vscode, do you know a way around that? ( I tried the button for +5secs but suspect that resets the EEprom too)

The other thing that's been funky is that sometimes while going through these steps, the Knomi suddenly emits a SSID that is all garbled up, like something was not translated correctly somewhere for the SSID.
I did that recently when I tried to manually set the STA SSID and password to see what that would do.

Log:

 *  Executing task: C:\Users\mklob\.platformio\penv\Scripts\platformio.exe device monitor --environment knomiv2

--- Terminal on COM3 | 115200 8-N-1
--- Available filters and text transformations: colorize, debug, default, direct, esp32_exception_decoder, hexlify, log2file, nocontrol, printable, send_on_enter, time
--- More details at https://bit.ly/pio-monitor-filters
--- Quit: Ctrl+C | Menu: Ctrl+T | Help: Ctrl+T followed by Ctrl+H
btn: 100
btn: 100
btn: 100
btn: 800
EEPROM reset factory
x�ESP-ROM:esp32s3-20210327
Build:Mar 27 2021
rst:0xc (RTC_SW_CPU_RST),boot:0x2b (SPI_FAST_FLASH_BOOT)
Saved PC:0x420d71ae
SPIWP:0xee
mode:DIO, clock div:1
load:0x3fce3808,len:0x44c
load:0x403c9700,len:0xbe4
load:0x403cc700,len:0x2a68
entry 0x403c98d4

------------- Knomi startup -----------

SPI Flash:
  Size: 16777216
  Speed: 80000000
  Mode: 0
SPI PSRAM:
  Found: 1
  Size: 8386279

------------------------------------------

******** LIS2DW12 startup *****

LIS2DW12 found!

******** LIS2DW12 init ok *****

knomi_config from default & INIT EEPROM
mdns hostname: KNOMI
knomi_config_require: AP
ap ssid: BTT-KNOMI
ap pwd:
ap ip: 192.168.20.1
ap mac: 4A:27:E2:F0:DB:38

dnsServer: 1
knomi_config_require: STA
mDNS start ok!
Scaning...
Scaning...
Scaning...
Scaning...
lv_wifi_status: Scaning...0

Scaning...
Scaning...
Scaning...
Scaning...
Scaning...
Scaning...
Scaning...
Scaning...
Scaning...
Scan ok!
knomi_config write to EEPROM
knomi_config_require: 16
para: 16
klipper ip: 192.168.86.29
knomi_config write to EEPROM
knomi_config_require: 10
para: 10
knomi_config_require: STA

sta ssid: MySpectrumWiFi10-5G
sta pwd: xxxxxxxxxxxxxxxx
.lv_wifi_status: 1
......................................................................sta ip: 192.168.86.49
lv_wifi_status: 2

MKloberg, 2023-11-21:
Can we please get some traction on this 'show stopper' issue?
Several customers are reporting the same thing now, rendering the device useless on their networks.
Please give this issue some level of escalation.
Thank you. :-)

Foose83, 2023-11-29:
Hello. I entered a shorter ssid and it works correctly now.

bigtreetech, 2023-12-06:
Hi Please try the latest version of firmware, this should solve the bug of not saving WiFi when password or name are long.
KNOMI2:
https://github.com/bigtreetech/KNOMI/blob/master/KNOMI2/Firmware/knomi2_firmware.bin
KNOMI1:
https://github.com/bigtreetech/KNOMI/blob/master/KNOMI1/Firmware/knomi1_firmware.bin
Follow the steps below to update:
https://github.com/bigtreetech/KNOMI/#firmware-update

alcaron, 2023-12-24:
Yeah the "choose file" button on Mac doesn't do anything...

Closed 2023-12-06.

Thread 38 (2023-11-12):

Knomi v2 Wi-Fi

3dbrooks, 2023-11-12:
Confirmed, Wi-Fi password is not retained after power is removed

3dbrooks, 2023-11-12:
Knomi V2...

3dbrooks, 2023-11-15:
I believe it briefly shows the logo and then back to the hello page with antenna connected . When I reconnect to it, the klipper IP is still in there but I must select my network from the list and recenter password. This did not happen at all with the original knomi

oMTEo, 2023-11-19:
I can also confirm this bug to my Knomi V1. After poweroff and on it 1st shows the Logo+circle then back to Hello-Page.

irgendwer92, 2023-11-23:
Same here on my Knomi V1

Foose83, 2023-11-23:
Same here on my Knomi V2

Foose83, 2023-11-29:
Hello. I entered a shorter ssid and it works correctly now.

oMTEo, 2023-11-29:
Ive tested now some WLAN-configurations with the presence of a team-member of BTT at discord and my results are : Passwords longer than 14 chars wouldnt keep hold after a powercycle of the Knomi. My SSID was only 3 chars at all tests.

I think (and hope) there will come an firmwareupdate soon :)

3dbrooks, 2023-11-29:
This is very exciting, will test with a shorter password. Thanks

MKloberg, 2023-12-01:
@oMTEo Wow, very cool find! My SSID is 19 characters long and the password 15 characters.
I can't change any of that without affecting 33 other devices on my network, so I also hope that this will be fixed soon now that we know what the problem is.

3dbrooks, 2023-12-01:
I changed my Wi-Fi password to 14 characters and my ssid is 6 characters and the issue remained. A second V2 behaves exactly the same. I have exhausted what I can do at my end.
  I even removed the antenna, Wi-Fi password and put knomi next to my router so it was the only network it saw and even that did not resolve issue.

oMTEo, 2023-12-01:
Damn that thing suckz really, I was sure we´ve found the Bug.

3dbrooks, 2023-12-05:
BTT sent me new firmware and it works!

emintjeee, 2023-12-05:
BTT sent me new firmware and it works!

bigtreetech, 2023-12-06:
Hi. The latest version of firmware should solve the bug of not saving WiFi when password or name are long.
KNOMI2:
https://github.com/bigtreetech/KNOMI/blob/master/KNOMI2/Firmware/knomi2_firmware.bin
KNOMI1:
https://github.com/bigtreetech/KNOMI/blob/master/KNOMI1/Firmware/knomi1_firmware.bin
Follow the steps below to update:
https://github.com/bigtreetech/KNOMI/#firmware-update

Guilouz, 2023-12-08:
@bigtreetech No change, same issue on KNOMI1

Bazeone, 2024-01-03:
same here.

milo1987, 2025-03-16:
same problems here! Wifi with 8 letters works, 14 not.

Closed 2023-12-06.

Thread 39 (2023-11-13):

STEP File for Knomi V2 Request

MKloberg, 2023-11-13:
Hello BTT,
 I'm working on bringing V2 into the Ender/Sprite Extruder world of 3D printing as part of the Taurus project, but would need a step file of the board as you had released in V1 already. Is that possible short term?
Shown is an early prototype of a new case for this application.
 Thank you.
Mac

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

Closed 2023-11-18.

Thread 41 (2023-11-18):

How do I Update Firmware?

BuschyX, 2023-11-18:
There are no .bin files on the firmware page and Visual Studio doesn't show any files that it can open.
I'm obviously missing something

mcbeenb, 2023-11-19:
I was able to generate the firmware following these steps:
1) Download and install VS code
2) Install platformIO extension (View->Extensions)
3) Install git https://git-scm.com/downloads
4) Grab the project form github by either cloning or downloading
5) Inside the project, Open Knomi -> Knomi1 -> firmware -> platformio.ini
6) Click build in the menubar

The bin files will be saved into .\KNOMI\KNOMI1\Firmware\.pio\build\esp32dev

BuschyX, 2023-11-19:
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

Thanks!

mcbeenb, 2023-11-19:
To upload the firmware to a Knomi1, you must go into dfu mode to connect.

Make sure your environment is ready, and you are getting serial timeouts when trying to connect. The next step must be done quickly.

Choose upload in vscode
hold down the reset button on knomi
insert usbc cable
release the reset button

This puts the device in DFU mode, like many other esp32 devices.

You should see the IDE begin to upload.

BuschyX, 2023-11-19:
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

I did the firmware upload via the web app and I did your way, neither threw any errors or confirmations really. Nothing to say it was already up to date. Just success. And from what I can see there is no way to check firmware on the device from the device. So I am just happy that I did not brick it in the process.

Thanks again, very helpful

mcbeenb, 2023-11-20:
Couple more quick things for anyone else attempting to update firmware, or as in my case, flashing a KNOMI1 to KNOMI2 firmware.

* There are two different firmware branches on the site currently. If you want to install the KNOMI2 branch, you need to select that branch when downloading. You can select this by either selecting the branch in the upper left of the code view or click the link in the readme.md that will take you to the other tree (https://github.com/bigtreetech/KNOMI/tree/firmware)
* Once you download this branch, you will need to set the env param in platformio.ini to KNOMI1. If you don't do this, you will get cpu mismatch errors when compiling.
* Flashing the KNOMI1 to KNOMI2 gives you the new hello page along with some of the new KNOMI2 features. Obviously there is no touch interface, but a lot of the realtime readouts don't appear to be pack ported either. At least from what I have seen so far. Very cool to see KNOMI1 getting a bit more love.

Hiccup-kzh, 2023-11-20:
Why do I encounter errors when I click on compile firmware
MissingPackageManifestError: Could not find one of 'package.json' manifest files in the package
![Uploading 8ERKC`U$]JNH{FM_LTT[{{4.png…]()

jeffalanmcclain, 2024-09-10:
> Why do I encounter errors when I click on compile firmware MissingPackageManifestError: Could not find one of 'package.json' manifest files in the package ![Uploading 8ERKC`U$]JNH{FM_LTT{{4.png…

I get the same error!  Trying to build a custom Knomi2 with different start up logo from the VORON gif.  Wish there was a way it could just be included as a resource in a directory and pulled in rather than having to convert the new GIF to hex and put in include .c file.

Thread 42 (2023-11-25):

Accelation display for Z shows almost alway full bar

lukicsl, 2023-11-25:
I have installed Knomi 2 on my Voron 2.4.
When running print the x any are showing some "reasonable" acceleration bar, the z bar is nailed to the top the most time, and sometimes s just drops 1-2 bars below max.
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

Is this a mechanical issue with the part cooling fan, of the hot end fan?

bigtreetech, 2023-12-06:
This is normal because there is gravitational acceleration (9.8 m/s²) in the z-axis direction

lukicsl, 2023-12-06:
Is this a joke or a bug? If not a joke, why not subtract the earth's g-force or at least make it configurable if somebody prints on a space lab or the moon?

jgefaell, 2023-12-07:
Me three. As it is, the Z-axis data is useless.

bigtreetech, 2023-12-08:
> Is this a joke or a bug? If not a joke, why not subtract the earth's g-force or at least make it configurable if somebody prints on a space lab or on the moon?

Got it. will change the logic here and remove the z-axis gravity acceleration

bigtreetech, 2023-12-15:
The latest version of firmware has subtracted 9.8 in the z-axis direction.

Closed 2023-12-15.

Thread 43 (2023-11-26):

Change UI color on V2 Firmware with V1 Display

VoltexRB, 2023-11-26:
Since the V1 display isnt a touchscreen, how do I use the color changing wheel?
I have tried changing the default color in the firmware in the config.h file, but that seems to break the device upon flashing so that I can no longer successfully put my Moonraker IP in the webinterface without it replacing it in the text field with random errors.

SrgntBallistic, 2023-12-19:
@VoltexRB did you figure this out?

Closed 2023-11-28.

Thread 45 (2023-11-30):

Knomi 2 custom gifs?

NeighNeighNeigh, 2023-11-30:
In the Knomi 1 manual there are instructions to customise the animations – this is a great feature. Is this still possible in Knomi 2? there's no mention of it that I could find.

bigtreetech, 2023-12-06:
same as knomi 1
https://bigtreetech.github.io/docs/KNOMI.html#customize-ui

NeighNeighNeigh, 2023-12-27:
Excellent thank you 🙏

Closed 2023-12-27.

Thread 46 (2023-12-01):

No saving and connection

MasterTrandem, 2023-12-01:
Hello,

I have the problem that the Knomi 2 don't save the wifinetwork. I change the ssid length but thats not helping. He only save the Ip from klipper.

The other problem is that Knomi says the printer is not opartional. When i reboot klipper you can see that Knomi have connection and show the reboot animation, but after thsn nothing. I have a Sonic Pad.

MasterTrandem, 2023-12-01:
Okay i found the problems. 1. The length of the moonrake_ip is the problem. Sonic Pad give every printer a own port. That means for section of the ip adress needs more len than 16. The other problem is the restore of the EEPROM. When it restore the password comes like this  � zBPZ�K��� out of the EEPROM.

MasterTrandem, 2023-12-02:
So i thing i fix the problems. For the moonraker IP i change in the config.h String moonraker_ip; // "192.168.255.255" max len =
from 16 to 22. For the reboot Problem  i change 2 things. First i write in the wifi_setup.cpp direct my SSID and password at .sta_ssid und .sta_pwd. Some was writing when he change the lengt iof the SSID the saves in the EEPROM work, because of this point  i change in the wifi_setup.cpp if (!EEPROM.begin()) from 1024 to 4096. I thing the space was not enouth.

oMTEo, 2023-12-02:
`// "192.168.255.255" max len =
from 16 to 22`
its just a comment and wont change anything

`(!EEPROM.begin()) from 1024 to 4096`
Ive tried this, but also doesnt fix this bug

MasterTrandem, 2023-12-02:
Okay than i don't know.
Sorry yes 😂 i forgot to say that i write the ip also inside the wifi_setup, but on the website i can see more than 16.
I make this with ChatGPT and he say to change this 16 to 22.
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

oMTEo, 2023-12-03:
ChatGPT.... XD, next time ask someone with basic programming skills :D

This :**7125** is Port-Direction and dont need to be written, only IP.

An IP -> **xxx.xxx.xxx.xxx** is 15 characters, so a length of 16 is enough.

MasterTrandem, 2023-12-03:
Yes but this was easier.
No i need the port for the Sonic Pad, because you can use 4 printer simultaneously. Every printer gets his own port. When i only give Knomi the IP he says that the printer is unoperative.

MasterTrandem, 2023-12-03:
Do

> `// "192.168.255.255" max len = 16` its just a comment and wont change anything
>
> `(!EEPROM.begin()) from 1024 to 4096` Ive tried this, but also doesnt fix this bug

Do you make a hard reset?

bigtreetech, 2023-12-06:
Hi Please try the latest version of firmware, this should solve the bug of not saving WiFi when password or name are long.
KNOMI2:
https://github.com/bigtreetech/KNOMI/blob/master/KNOMI2/Firmware/knomi2_firmware.bin
KNOMI1:
https://github.com/bigtreetech/KNOMI/blob/master/KNOMI1/Firmware/knomi1_firmware.bin
Follow the steps below to update:
https://github.com/bigtreetech/KNOMI/#firmware-update

Guilouz, 2023-12-08:
@bigtreetech Always the same issue on KNOMI1

claudioguareschi, 2023-12-09:
> Hi Please try the latest version of firmware, this should solve the bug of not saving WiFi when password or name are long. KNOMI2: https://github.com/bigtreetech/KNOMI/blob/master/KNOMI2/Firmware/knomi2_firmware.bin KNOMI1: https://github.com/bigtreetech/KNOMI/blob/master/KNOMI1/Firmware/knomi1_firmware.bin Follow the steps below to update: https://github.com/bigtreetech/KNOMI/#firmware-update

@bigtreetech
The new firmware still has a problem of not saving the web interface data correctly.
The issue is in wifi_setup.cpp in the eeprom write function:

  EEPROM.put<knomi_config_t>(0x00 + sizeof(EEPROM_SIGN), knomi_config);

The size of EEPROM_SIGN (4 bytes) is not returned correctly by sizeof(EEPROM_SIGN).

Change to
  EEPROM.put<knomi_config_t>(0x00 + **EEPROM_SIGN_SIZE**, knomi_config);
as it was correctly done in the rest of the code.

The older firmware version worked just fine after this change, without the need to convert strings to char[]

Coolbobjoe, 2023-12-17:
Has this been fixed? I tried the stock firmware, no dice, i tried flashing the new firmware nothing, so far ive had 0/4 brand new BTT products have limited or absolutely no functionality. Getting close to the point of sending back the entire shipment!

Jinxted, 2023-12-26:
This has not been fixed in the most current firmware. The issue is we need to be able to enter the port. Not everyone is using a printer that comes stock with vanilla Klipper and Moonraker. People using printers like the K1 Series or the Sonic Pad are stuck needing to have a port set in order to communicate with Moonraker appropriately. Without the ability to tell the Knomi which port to access, we have paperweights. I wish I had not updated my Knomi firmware because the ancient version allowed the port to be set within the ip address. Now I have a Knomi I cannot use.

Jinxted, 2023-12-26:
I take that back - for the v1, the link in the readme and such that points to the "latest" firmware has not been updated to include the actual newest firmware release. I flashed the firmware from https://github.com/bigtreetech/KNOMI/tree/master/KNOMI1/Firmware and it now has a field for the port and is functioning correctly. Update to the newest firmware in the actual repository and do not use any of the current links that download a pre-zipped file with existing older firmware.

Thread 48 (2023-12-07):

Kmoni V2.0 does not allow TCP Port specification for Klipper Host

jgefaell, 2023-12-07:
The IP address field only allows for 16 characters. This does not allow for a port specification which is necessary for multiple printer Klipper configurations as well as for the Creality K1. The device cannot be used for these printers.

I, for instance, have three printers connected to two Klipper hosts, and a Creality K1 Max. I cannot use Knomi V2.0 with three of these printers.

Note that Knomi V1.0 allowed the port specification, so this should be considered a regression.

Thank you for your consideration. I'm keen to make use of Knomi V2.0!

bigtreetech, 2023-12-08:
Got it.  Do it now.

lech91, 2023-12-14:
> Got it. Do it now.

I dont get it, is it fixed? I installed the new firmware and wasnt able to add the port

bigtreetech, 2023-12-14:
> > Got it. Do it now.
>
> I dont get it, is it fixed? I installed the new firmware and wasnt able to add the port

Please try the the latest version of firmware again. Just uploaded the precompiled binaries now.

If you want to know the details of the changes, you can view the commit here
https://github.com/bigtreetech/KNOMI/commits/firmware/

Closed 2023-12-14.

Thread 49 (2023-12-14):

Kinomi v2 OV2640 camera interface

Xerusen, 2023-12-14:
Is there any way to use OV2640 interface? kinomi 2 was advertised to be able to use camera and humidity sensor
currently software doesn't take advantage of that

Xerusen, 2023-12-14:
There is also lis2dw12 accelerometer mentioned, but no instruction on how to use any of those features

Coolbobjoe, 2023-12-17:
Following as I also bought this with these interests in mind!

Bazeone, 2024-01-11:
same here

azak1r, 2024-03-30:
would love to use my 3do nozzle cam from the knomi... saves on wire runs

rebel1985, 2024-04-02:
me too

dukes4, 2024-06-23:
Any update please ?

BTopbas, 2024-07-17:
Up

salbang, 2024-07-21:
Up

benbender, 2024-08-01:
@bigtreetech any news?

thejoshuahenry, 2025-03-26:
Apparently this person got the camera working: https://github.com/OmeeeChan/Knomi-V2-camera-function/tree/main

500Foods, 2025-03-26:
Kinda vague on the details tho 😀

thejoshuahenry, 2025-03-26:
Indeed... I assume just flash that firmware, connect a compatible OV2640 camera, then... navigate to the Knomi web address and grab the webcam stream. Just guessing - will need to get a camera module to try.

500Foods, 2025-03-26:
We'll just take it on faith that some random firmware.bin loaded into a device with WiFi and camera hardware is good to go? I mean, sure, I like it, but it just strikes me as funny. But then again, maybe this is the guy who originally designed it, so who knows! Still funny 😆

Thread 50 (2023-12-20):

Potential short when installing knomi v2 according to manual!! - destroying your can board

k4ndr3, 2023-12-20:
Manual flawed at pages 9, 10, 11
Expirienced the consequences 1st hand. Was not paying attention and destroyed my canbus board and the toolboard.

here is the problem:

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

the manual even shows you the consequence

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

KoiosLabs, 2024-07-09:
I put some uv solder mask on mine, would recommend similar... electrical tape... kapton... anything

donaldkieu, 2025-04-23:
Just blew up 2 daughter boards because of this antenna

Thread 51 (2023-12-24):

Unable to compile latest firmware

rahsaankcole, 2023-12-24:
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

thijstriemstra, 2023-12-30:
Use this pull request to fix it: https://github.com/esphome/AsyncTCP/pull/6

eg:

```
lib_deps    =
              LIS2DW12=https://github.com/stm32duino/LIS2DW12/archive/refs/tags/2.1.0.zip
              Adafruit_SHT4X=https://github.com/adafruit/Adafruit_SHT4X/archive/refs/tags/1.0.3.zip
              lvgl=https://github.com/lvgl/lvgl/archive/refs/tags/v8.3.7.zip
              bblanchon/ArduinoJson@^6.19.4
              TFT_eSPI=https://github.com/Bodmer/TFT_eSPI/archive/refs/tags/v2.5.0.zip
              ; https://github.com/me-no-dev/ESPAsyncWebServer.git
              ; https://github.com/ayushsharma82/AsyncElegantOTA.git
              ottowinter/ESPAsyncWebServer-esphome @ ^3.1.0
              https://github.com/bigtreetech/AsyncElegantOTA.git
              ; Use https://github.com/esphome/AsyncTCP/pull/6 to fix
              ; https://github.com/esphome/issues/issues/5258
              https://github.com/HeMan/AsyncTCP.git#CI-and-fix
```

thijstriemstra, 2024-01-11:
> I had these errors when attempting to compile. I

I also ran into that issue, seems it's broken with 6.5.0 platform so use 6.4.0 instead:

```ini
platform = espressif32@6.4.0
```

BoothyBoothy, 2024-01-11:
> I also ran into that issue, seems it's broken with 6.5.0 platform so use 6.4.0 instead

Thank you, I will give it a try later

BoothyBoothy, 2024-01-11:
Thank you again, that worked to an extent but now get the error you previously commented on in the thrtead. I am really still not quite sure how you implement the suggested PR? Is it simply a matter of copying the lib_deps info to a specific file? I could not see an obvious place to paste? Thanks again Boothy
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

thijstriemstra, 2024-01-11:
put PR url in `lib_deps` like I showed in comment above: https://github.com/bigtreetech/KNOMI/issues/51#issuecomment-1872545192

BoothyBoothy, 2024-01-11:
Thank you thank you........I was being really thick there:) Has now complied successfully!

mkryuchkov, 2024-05-26:
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

You saved my day!

Thread 52 (2023-12-27):

Rotate display 180°

NeighNeighNeigh, 2023-12-27:
I'm hoping it might be possible to set the display to rotate 180°? This would allow for additional mounting options with the USB port at the top instead of the bottom. Is this possible?

NeighNeighNeigh, 2023-12-27:
For example, here's a mount I have been mocking up. At this angle with the Knomi 2 tilted upward toward the viewer, it's not possible to orient the device with the USB port at the bottom.

https://github.com/bigtreetech/KNOMI/assets/4795315/7be7d433-1da6-494a-95c2-04cfd196a1ee

NeighNeighNeigh, 2023-12-27:
Never mind. I realise you don’t need the USB to be plugged in all the time, so it’s a non-issue 🤦‍♂️

Closed 2023-12-27.

Thread 53 (2024-01-15):

KNOMI 2 3do camera

rmilyard, 2024-01-15:
Is there a version for use with the Knomi 2 and 3do 4k Nozzle cam?

rebel1985, 2024-04-03:
i'm also searching for it

Thread 56 (2024-01-23):

Knomi2 you can get stuck in the preheat screen if you set the goal temp below the ambient temp of the room

sprior, 2024-01-23:
With the Knomi 2, if the ambient room temp is for example 19 degrees C and you swipe to the preheat screen and press the button to preheat the bed, then press the check button while the setting is above 0 but below the ambient room temp, the Knomi 2 will be stuck on the preheating screen with no way to swipe out.  The only way to recover is to use some other control interface of the printer and turn the heaters off.

sprior, 2024-01-23:
The easiest solution might be when you go to the set temp screen for preheat, instead of the default value being 0 set the default to the current temp.  That way you'll never be able to set it to a temp below what the bed or hot end can reach and the preheating screen would be satisfied immediately.  If you want to turn off the heater there's a cooldown button on another screen to use.

sprior, 2024-01-23:
I believe the temp wheel actually lets you select a value below zero which is pretty silly.  There should be some reasonable constraints on the values that can be selected.

Thread 58 (2024-01-26):

Unable to get connect KNOMI or KNOMI 2 to Voron using OctoPrint

TitanColossus, 2024-01-26:
Not sure if this is an issue with the Klipper Port (not sure what this is) or if it is the fact that I am using OctoPrint

Keeps saying Printer is Unoperational Please Check your Printer on the KNOMI 2 and the KNOMI 1 stays on the standby screens.

TheSin-, 2024-04-07:
This is Octoprint, Octoprint has a buffer and doesn't use the virtual SD, moon raker won't set the printing status unless virtual SD is used.  I'm in the same boat and I've been trying to thing or a way to fake it.

TitanColossus, 2024-04-07:
I ended up just reinstalling and using Mainsail and moonraker. Works great now.On Apr 7, 2024, at 03:04, Justin F. Hallett ***@***.***> wrote:
This is Octoprint, Octoprint has a buffer and doesn't use the virtual SD, moon raker won't set the printing status unless virtual SD is used.  I'm in the same boat and I've been trying to thing or a way to fake it.

—Reply to this email directly, view it on GitHub, or unsubscribe.You are receiving this because you authored the thread.Message ID: ***@***.***>

amangasas, 2025-01-31:
you can use https://github.com/cp2004/OctoPrint-VirtualPrinterSettings/releases/latest/download/release.zip
if you use moonraker

Thread 59 (2024-01-30):

Knomi 2 and K1 Screen

Myklt8, 2024-01-30:
When I installed the Knomi and booted up my K1. The K1 screen boots but then goes black
is it supposed to take over for the printer's UI? I really need to start some prints from the printer screen
Any fix for this?

debemdeboas, 2024-05-14:
I'm thinking of buying a Knomi 2 and I'd like to know if the screen becomes inoperable after installing the Knomi 2.

Myklt8, 2024-05-14:
Mine ended up being an issue with changing the probe points. The screen worked fine with the Knomi after I sorted it out 

Yahoo Mail: Search, Organize, Conquer

  On Tue, May 14, 2024 at 3:44 PM, rafael de ***@***.***> wrote:

I'm thinking of buying a Knomi 2 and I'd like to know if the screen becomes inoperable after installing the Knomi 2.

—
Reply to this email directly, view it on GitHub, or unsubscribe.
You are receiving this because you authored the thread.Message ID: ***@***.***>

Thread 60 (2024-01-30):

Unable to update Knomi1 firmware

appleimperio, 2024-01-30:
After following your instructions using the ESP32 flash tool it always stay in sync no progress and in the terminal window there are dots added one by one. Left for more than 8 hours and nothing. The connection is good because If I remove the cable the windows show from sync to error, and I already try another cable same story.

````
dl_list:
[['C:|\Users\\macim|\Downloads\\knomi1_bootloader.bin',
4096], ['C:\\Users\\macim\\Downloads\\knomi1_partitions.bin', 32
7681, ['C:\\Users|\macim|\Downloads||knomi1_firmware.bin', 65536]]
[4096, 32768, 65536]
['C:\\Users\\macim\\Downloads\|knomi1_bootloader.bin', 'C:||Users\\macim\\Downloads\\knomi1_partitions.bin', 'C:||Users\\
macim| \Downloads|\knomi1_firmware.bin'] i:
1
i:
2
test offset : 4096 0x1000
case ok
test offset : 32768 0x8000
case ok
test offset : 65536 0x10000
case ok
・・・・・・・・・・・・・・・・・・・・・・・・・・・・・・・・・・・・・
````

Closed 2024-01-31.

Thread 62 (2024-02-07):

Knomi 2 V1.0.2 Accel Display Y and Z reversed?

MKloberg, 2024-02-07:
I'm not sure if anybody else has seen this yet. New one, but bought a while back - haven't actually used it until yesterday.
I flashed it with the latest firmware.bin and put it on the printer.
While it completes a layer, I see blips on the x and z but next to nothing on the y.
I don't use z-hop, so there should be next to nothing on the z, unless going up to the next layer.
I see almost nothing on the Y, almost if the two were reversed.
Is anyone else seeing this?

MKloberg, 2024-02-11:
Please ignore my previous issue, I just didn't understand how the Knomi renders these bars.

During printing, it will display three acceleration bars, one for each axis.
Looking at the source code, I learned that the values that are driving these bars are not coming from Klipper. Instead, the sensor that makes this possible is a LIS2DW12 3-axis MEMS accelerometer and mounted on the Knomi PCB itself, sensing how the Knomi moves through 3D space.

If you read this far, you most likely have a bed-slinger style printer, and the print head will only accelerate in the x and z directions while it moves during printing (never in the y direction because that is the axis of the bed). The acceleration bar for the Y axis will therefore never really move and remain mostly at zero.

There should be a configurable option to specify if the printer is a bed-slinger or corexy style printer.
Consequently, for bed-slingers - perhaps there are values on the Moonraker api for each axis that could be displayed to make this somewhat interesting instead of the LIS2DW12 accelerometer values.

austinrdennis, 2024-05-07:
Wow, I agree. This might be the worst implementation of a feature I've ever seen. Agreed, just hook it into moonraker and have it look at instantaneous velocity changes on each axis. This decision is just kinda wild.

Thread 63 (2024-02-10):

Knomi 2 Macro G28 called recursively

rmilyard, 2024-02-10:
When trying to home printer with sensorless-homing,cfg we are getting error: Macro G28 called recursively

What is going on?  I believe I have newest firmware that was posted 2 months ago.

Biffes, 2024-02-27:
Got this problem too. Maybe it is a collision between the sensorless.cfg and the knomi macro. Mainsail console logs about five g28 commands while the error happens.

Specker, 2024-02-29:
I was able to solve this.
if you have a `[homing_override]` in your `printer.cfg` you will have to change `G28` in there with `G28.1`.
Similar to mine:
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

Biffes, 2024-03-02:
Thanks for the reply, Specker!
I tested your solution and it worked! But i had to change the G28s in the sensorless.cfg too. I found another solution after looking for a fix to the bed mesh calibration for kamp here:
https://github.com/bigtreetech/KNOMI/issues/25

I simply changed the makros in my sensorless.cfg like this:

{% if home_all or 'X' in params %}
    SET_GCODE_VARIABLE MACRO=_KNOMI_STATUS VARIABLE=homing VALUE=True
    _HOME_X
    SET_GCODE_VARIABLE MACRO=_KNOMI_STATUS VARIABLE=homing VALUE=False
  {% endif %}

  {% if home_all or 'Y' in params %}
    SET_GCODE_VARIABLE MACRO=_KNOMI_STATUS VARIABLE=homing VALUE=True
    _HOME_Y
    SET_GCODE_VARIABLE MACRO=_KNOMI_STATUS VARIABLE=homing VALUE=False
  {% endif %}

  {% if home_all or 'Z' in params %}
    SET_GCODE_VARIABLE MACRO=_KNOMI_STATUS VARIABLE=homing VALUE=True
    G90
    G0 X150 Y150
    G28 Z
    G1 Z10
    SET_GCODE_VARIABLE MACRO=_KNOMI_STATUS VARIABLE=homing VALUE=False

Worked perfectly and i dont have to mess around with modified G28s.

jeffalanmcclain, 2024-09-11:
It is STUPID that this is still an OPEN issue and affecting even pretty base setups.  Thanks for your help figuring this out (I have same issue on bed mesh too).  This is on FlashForge 5M Pro running KlipperMOD.  And I managed to recompile new FW with a new graphic for the start too!
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

jeffalanmcclain, 2024-09-11:
Ok, I found a slightly BETTER way to do this.  I don't like having to edit other config files when I add things (like knomi).  And I really don't want things to break if I stop including knomi.cfg with the redefined macros intercepts.  And, it looks like the problem is that [homing_override] is a pretty special macro that does NOT go through the macro rename checks first, it just calls RAW G28 even if you redefine G28.  And it doesn't work to redefine G28 rename old to G28.1 THEN create [homing_override] last.  HOWEVER, Klipper doesn't seem to complain if you REDEFINE [homing_override] again later.  So, I cut and paste the original [homing_override] from my config that runs earlier, and paste it at the bottom of my knomi.cfg and change it THERE to have the hard coded G28.1 calls and it works beautifully (it would be better if defining the routine AFTER the rename G28 to G28.1 would just work with G28, but it don't).  Now, if I ever want to remove knomi, I just remove the [include knomi.cfg] and the original [homing_override] never gets stomped and everything works.

xdased14x, 2024-10-20:
> Ok, I found a slightly BETTER way to do this. I don't like having to edit other config files when I add things (like knomi). And I really don't want things to break if I stop including knomi.cfg with the redefined macros intercepts in the revised [homing_override]. And, it looks like the problem is that [homing_override] is a pretty special macro that does NOT go through the macro rename checks first, it just calls RAW G28 function even if you redefine G28 (it doesn't call your new macro). And it doesn't work to redefine G28 rename old to G28.1 THEN create [homing_override] last (I was hoping it would try to resolve whatever was in place at that point, but it doesn't). HOWEVER, Klipper doesn't seem to complain if you REDEFINE [homing_override] again later (and, no, you can't do rename_existing: in homing_override..Klipper doesn't allow it...sigh). So, I cut and paste the original [homing_override] from my printer.base.cfg that runs / includes in printer.cfg earlier, and paste it at the bottom of my knomi.cfg and change the G28 to G28.1 THERE locally and it works beautifully. It would be better if defining the routine AFTER the rename G28 to G28.1 would just work with G28, but it don't. Now, if I ever want to remove knomi, I just remove the [include knomi.cfg] and the original [homing_override] that is still untouched never gets stomped and everything works.

can you show me the knomi cfg you use trying to fix mine

jeffalanmcclain, 2024-10-20:
well, mine is quite a bit different from anything anyone uses because I have a pretty custom status for LED control and a bunch of other things all broken out...but I can add it here.  Doubt it helps.

`[gcode_macro _KNOMI_STATUS]
variable_homing: False
variable_probing: False
variable_qgling: False
variable_heating_nozzle: False
variable_heating_bed: False
gcode:

[gcode_macro _STATUS_KNOMI]
gcode:
	{% set status = printer['gcode_macro _STATUS_VARIABLES'].printer_status %}
#	{ action_respond_info("Printer status in KNOMI.CFG is: " ~ status) }
	{% if status in ["READY", "PRINTING", "BUSY", "HEAT_SOAKING", "HEAT_SOAKING_END"] %}
		SET_GCODE_VARIABLE MACRO=_KNOMI_STATUS VARIABLE=homing VALUE=False
		SET_GCODE_VARIABLE MACRO=_KNOMI_STATUS VARIABLE=probing VALUE=False
		SET_GCODE_VARIABLE MACRO=_KNOMI_STATUS VARIABLE=qgling VALUE=False
		SET_GCODE_VARIABLE MACRO=_KNOMI_STATUS VARIABLE=heating_nozzle VALUE=False
		SET_GCODE_VARIABLE MACRO=_KNOMI_STATUS VARIABLE=heating_bed VALUE=False
	{% elif status == "HEATING_EXTRUDER" %}
		SET_GCODE_VARIABLE MACRO=_KNOMI_STATUS VARIABLE=heating_nozzle VALUE=True
	{% elif status == "HEATING_EXTRUDER_END" %}
		SET_GCODE_VARIABLE MACRO=_KNOMI_STATUS VARIABLE=heating_nozzle VALUE=False
	{% elif status == "HOMING" %}
		SET_GCODE_VARIABLE MACRO=_KNOMI_STATUS VARIABLE=homing VALUE=True
	{% elif status == "HOMING_END" %}
		SET_GCODE_VARIABLE MACRO=_KNOMI_STATUS VARIABLE=homing VALUE=False
	{% elif status == "HEATING_BED" %}
		SET_GCODE_VARIABLE MACRO=_KNOMI_STATUS VARIABLE=heating_bed VALUE=True
	{% elif status == "HEATING_BED_END" %}
		SET_GCODE_VARIABLE MACRO=_KNOMI_STATUS VARIABLE=heating_bed VALUE=False
	{% elif status == "BEDMESH" %}
		SET_GCODE_VARIABLE MACRO=_KNOMI_STATUS VARIABLE=probing VALUE=True
	{% elif status == "BEDMESH_END" %}
		SET_GCODE_VARIABLE MACRO=_KNOMI_STATUS VARIABLE=probing VALUE=False
	{% elif status == "EVELING" %}
		SET_GCODE_VARIABLE MACRO=_KNOMI_STATUS VARIABLE=qgling VALUE=True
	{% elif status == "EVELING" %}
		SET_GCODE_VARIABLE MACRO=_KNOMI_STATUS VARIABLE=qgling VALUE=False
#	{% elif status == "CRITICAL_ERROR" %}
#	{% elif status == "NOZZLE_CLEANING" %}
	{% endif %}
`

selrahc13, 2025-03-08:
> > Ok, I found a slightly BETTER way to do this. I don't like having to edit other config files when I add things (like knomi). And I really don't want things to break if I stop including knomi.cfg with the redefined macros intercepts in the revised [homing_override]. And, it looks like the problem is that [homing_override] is a pretty special macro that does NOT go through the macro rename checks first, it just calls RAW G28 function even if you redefine G28 (it doesn't call your new macro). And it doesn't work to redefine G28 rename old to G28.1 THEN create [homing_override] last (I was hoping it would try to resolve whatever was in place at that point, but it doesn't). HOWEVER, Klipper doesn't seem to complain if you REDEFINE [homing_override] again later (and, no, you can't do rename_existing: in homing_override..Klipper doesn't allow it...sigh). So, I cut and paste the original [homing_override] from my printer.base.cfg that runs / includes in printer.cfg earlier, and paste it at the bottom of my knomi.cfg and change the G28 to G28.1 THERE locally and it works beautifully. It would be better if defining the routine AFTER the rename G28 to G28.1 would just work with G28, but it don't. Now, if I ever want to remove knomi, I just remove the [include knomi.cfg] and the original [homing_override] that is still untouched never gets stomped and everything works.
>
> can you show me the knomi cfg you use trying to fix mine

You are a genius. This worked perfectly, thank you.

selrahc13, 2025-03-08:
> Ok, I found a slightly BETTER way to do this. I don't like having to edit other config files when I add things (like knomi). And I really don't want things to break if I stop including knomi.cfg with the redefined macros intercepts in the revised [homing_override]. And, it looks like the problem is that [homing_override] is a pretty special macro that does NOT go through the macro rename checks first, it just calls RAW G28 function even if you redefine G28 (it doesn't call your new macro). And it doesn't work to redefine G28 rename old to G28.1 THEN create [homing_override] last (I was hoping it would try to resolve whatever was in place at that point, but it doesn't). HOWEVER, Klipper doesn't seem to complain if you REDEFINE [homing_override] again later (and, no, you can't do rename_existing: in homing_override..Klipper doesn't allow it...sigh). So, I cut and paste the original [homing_override] from my printer.base.cfg that runs / includes in printer.cfg earlier, and paste it at the bottom of my knomi.cfg and change the G28 to G28.1 THERE locally and it works beautifully. It would be better if defining the routine AFTER the rename G28 to G28.1 would just work with G28, but it don't. Now, if I ever want to remove knomi, I just remove the [include knomi.cfg] and the original [homing_override] that is still untouched never gets stomped and everything works.

You are a genius. This worked perfectly. Thank you.

SamppaD78, 2025-05-07:
As to be expected with BTT products,issues that will be never resolved by BTT support. I have exactly the same issue with knomi 2, macro G28 called recursively error. In the process of finding the issue with it updated Klipper and mainboard mcu but still the same issue. As i have a fully working config i dont want to mess with modifying printer .cfg files,so  I was looking for a simple solution as this one below...problem is that i cant find homing_overide in my printer.cfg? I have a voron 2.4r2 with clickyprobe and stock endstops. How to solve this,any help will be appreciated. Thanks.

> > Ok, I found a slightly BETTER way to do this. I don't like having to edit other config files when I add things (like knomi). And I really don't want things to break if I stop including knomi.cfg with the redefined macros intercepts in the revised [homing_override]. And, it looks like the problem is that [homing_override] is a pretty special macro that does NOT go through the macro rename checks first, it just calls RAW G28 function even if you redefine G28 (it doesn't call your new macro). And it doesn't work to redefine G28 rename old to G28.1 THEN create [homing_override] last (I was hoping it would try to resolve whatever was in place at that point, but it doesn't). HOWEVER, Klipper doesn't seem to complain if you REDEFINE [homing_override] again later (and, no, you can't do rename_existing: in homing_override..Klipper doesn't allow it...sigh). So, I cut and paste the original [homing_override] from my printer.base.cfg that runs / includes in printer.cfg earlier, and paste it at the bottom of my knomi.cfg and change the G28 to G28.1 THERE locally and it works beautifully. It would be better if defining the routine AFTER the rename G28 to G28.1 would just work with G28, but it don't. Now, if I ever want to remove knomi, I just remove the [include knomi.cfg] and the original [homing_override] that is still untouched never gets stomped and everything works.
>
> You are a genius. This worked perfectly. Thank you.

Thread 69 (2024-04-06):

Screen Brightness is very faint

JLutt88, 2024-04-06:
My V2 knomi was working fine and im really happy with it, however ive had an issue since last turning on my printer. the screen at first seemed like it wouldn't turn on so i removed it from the SB shell to trouble shoot the issue on the computer. The screen doesnt actually turn off but is however very very faint (you need to look hard to see that its still on). the knomi still connects to the network and other than the screen issue is working fine. has anyone encountered this or can you suggest what might be causing the issue? any help would be greatly appreciated.

thanks

Thread 70 (2024-05-17):

SCREEN BLACK AFTER UPLOAD GIF

CAIOCDK1, 2024-05-17:
My KNOMI V2 had a black screen after uploading a new GIF, I can't do anything else, not even access the webpage to connect, It also no longer appears as an option on the wifi, nothing happens, I remove the USB and insert it, and only the red light appears in board, not even the Hello message. I can only upload it through VSCODE, but it doesn't seem to have any effect, it completes the process with the SUCCESS message, but the screen remains black.

Rami-Pastrami, 2024-05-18:
Same thing happened with me with 2 separate Knomi v2 boards

electrocally, 2024-05-19:
This also happened to my Knomi v2 yesterday.

I originally used the web UI at `http://knomi.local` to flash the new gif, following a review & tutorial from [HobbyistNotes on YouTube](https://www.youtube.com/watch?v=EckKEoBZAGw&t=193s). Exact same issues as described above by @CAIOCDK1 with no screen or WIFI network.
I've attempted to use both the Flash Download Tool (same error code "2-sync fail" as @Rami-Pastrami) [documented here](https://bttwiki.com/KNOMI.html#update-firmware), and VSCode using PlatformIO.  Although it has no effect, PlatformIO's output insists that it is able to both write & confirm the hash of the new firmware.

Output snippet:
```
...
Wrote 2939840 bytes (1413934 compressed) at 0x00010000 in 36.2 seconds (effective 650.3 kbit/s)...
Hash of data verified.

Leaving...
Hard resetting via RTS pin...
================================================================================================================ [SUCCESS] Took 70.66 seconds ================================================================================================================

Environment    Status    Duration
-------------  --------  ------------
knomiv2        SUCCESS   00:01:10.661
================================================================================================================= 1 succeeded in 00:01:10.661 =================================================================================================================
 *  Terminal will be reused by tasks, press any key to close it.
 ```

electrocally, 2024-05-19:
**I have a fix!**

Posted to the BigTreeTech channel of the Voron Discord & saw a few others had the same issue previously.

The firmware update documentation is for the Knomi **v1**, and hasn't been updated for v2.

At the start of the flashtool screen, select `ESP32-S3`
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

From this repository cloned locally, you can flash the default firmware in the master branch. Be sure to select that in the  `KNOMI2/Firmware` folder.

One important difference is that the `knomi2_bootloader.bin` needs the memory address `0x0`. Select your COM port from the dropdown menu.
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

Rami-Pastrami, 2024-05-19:
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

This works on bringing back the knomi v2 from death with the stock firmware! Thanks for the heads up!

The one thing remaining is that any firmware I compile fails again with the black screen issue. I thought maybe the gif I was using was at fault, but even when I change 1 C file with one of the original gifs, it still fails like this

electrocally, 2024-05-19:
I was originally just very happy to have my Knomi working again, but I also couldn't get it to run the firmware I compiled.

I'm now leaning towards the conclusion that my board, or perhaps this newer batch of boards that we have, are faulty. The box mine arrived in says "D/C: 2024.2.24" on.

Once mine worked from my comment above, I tried the web UI updater using the same firmware.bin I'd used with the USB flashing tool -- it didn't crash or brick at the time. _but_ when I turned my printer off and on, the toolhead (SB2209 RP2040) wouldn't start & everything smelled like solder.
Seems to be short-circuit protection and the Knomi has somehow shorted out.

My Knomi no longer runs, not even in DFU mode, nor has a red light over USB, but does get **extremely** hot when plugged in.
I'll be reaching out to BTT's customer service.

CAIOCDK1, 2024-05-20:
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

**This solves the problem, my Knomi came back, and I had already done this process, with just one different detail: the instruction number in the bootloader, I was using 0x1000**

mkryuchkov, 2024-05-26:
Still can't get something other than black screen with compiled firmware, even stock option (same commit as precompiled one). Any suggestions/solutions?

mkryuchkov, 2024-05-26:
Answer which worked for me https://github.com/bigtreetech/KNOMI/issues/51#issuecomment-1887664967

spigrex, 2024-07-24:
Did anyone ever figure a way around this. I have the same issue. Pre compiled firmware works fine (ever others custome pre compiled firmware worked!) But when I flash anything I compiled/built, I just get the black screen. Tried everything I can find through the issues. I assume it must be a version or something thats out of sync as firmware that others have compiled works on my screen. It's very frustrating and I can see others are having the same issue (which kinda makes me feel a little better about the situation haha)

mkryuchkov, 2024-07-25:
@spigrex look my latest comment

> Answer which worked for me https://github.com/bigtreetech/KNOMI/issues/51#issuecomment-1887664967

TL;DR: use 6.4.0 framework

```
platform = espressif32@6.4.0
```

spigrex, 2024-07-25:
What does this do sorry? Like how do I run this in a terminal? This seems like it fixes an issue with compiling/building errors and has nothing to do with the knomi resulting in a black screen after flashing (sorry if I'm being stupid here!)

spigrex, 2024-07-26:
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

Ah you star! This totally solved my issue ...can stop pulling my hair out over this now! ...just changed the env:knomiv2 in platformio.ini and it flashed fine

Thanks ...feel so silly that it was this simple.

Closed 2024-05-20.

Thread 71 (2024-05-26):

Screensaver automatic Dim option

Matrice666, 2024-05-26:
Hello everyone,

Would it be possible to add an option for the backlight and display to automatically go dimmer after a set time of no action or change?
A bit like a screensaver mode if you will.

 Standby is cool but it really doesn't need to be as bright as when things are being adjusted on the display.

 KNOMI could literally fall asleep after a few minutes and dim itself. Be startled when woken up, brighten up. (adjust stuff, adjust stuff) repeat cycle.

 Could also have the option during prints.

 Just an idea. Have a great day.

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

Thread 75 (2024-06-13):

knomi v2 black screen

bodydropped72, 2024-06-13:
configured knomi2 for my k1 max. was working fine, started a print then came back to check and the screen on knomi was black. will not respond to touch, light on back of device is red so i know theres power. anyone run into this issue?

borysne, 2024-07-07:
try to reflash! use the instructions for flashing the firmware from Knomi 1, use USB and the flash_download_tool program
bootloader change 0x0. that's how I did it!  https://youtu.be/3zP8yZpm3ds
I have a different problem) I can’t reflash the custom firmware, only the original one!

Thread 76 (2024-06-15):

Epic CAD errors on to many files.

BlackNet, 2024-06-15:
So, Solidworks reports an easy 1500-ish error in each step file in this repo.
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

Take the above screenshot, for example; it shows faulty gaps and faces. Would it be possible to publish better-quality CAD files?

Thread 77 (2024-06-19):

ERCF pause not shown on the Knomi

gneu42, 2024-06-19:
I'm using the Knomi 2 as a remote monitor for my Voron V2 printer. I'm also using ERCF on that printer.
I noticed that when ERCF has an error , it goes to pause, but the Knomi does not show the pause.
This is the main reason I use the Knomi.
How can I get it to show the pauses generated by ERCF ?

Thread 78 (2024-07-07):

Knomi v2 Can't flash through VS code

borysne, 2024-07-07:
I'm trying to flash Knomi v2 but unfortunately nothing works! The firmware is built in VS code using the platformIO , but when I flash the screen is always black, I tried different firmware, all the firmware that is built through PIO does not work! I tried to flash the firmware built by PIO via USB, and flash_tool did not work! To restore Knomi after firmware failures, I use Flash_tool and flash the Bin file from the official website! I've already tried everything and can't figure out where my mistake is??? please help
I recorded a video, maybe you’ll see something that I didn’t notice!  https://youtu.be/3zP8yZpm3ds

spigrex, 2024-07-22:
I'm also having this issue, I've tried other custom firmware and they work, so I assume it's something I'm doing wrong. I'm not new to vscode/platform io, but this has me totally stumped.
I've tried using an older version of vscode and platform io just in case that was it, and used an older laptop with a fresh install of older versions of vscode and platform io and the newest versions with no luck. Always black screen. I'd live to know how some people made their custom firmware and what versions they are using.

spigrex, 2024-07-22:
I fixed my issue at least ...seems dumb that I didn't think of it lol. I included the bootloader and partitions bin files when flashing using the esp flash download tool (esp32-c3) I used 0x10000 for all three and it worked
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

borysne, 2024-07-23:
Hello! Is there a video of how you flashed it and it works? can you use OTA to update? access to USB will be closed when you assemble KNOMI into a case

spigrex, 2024-07-23:
Il try and get a video later today. So ota still resulted in the same issue. Black screen. The only way I could flash it was using the tool and the three files.
I had a long play around with it last night, and no matter what I do,  the gifs don't change. I edited the gif files to yellow instead of red, converted them, copied them into the orinigal location. Compiled, flashed, all seemed to work, but all the gifs were the same red color, which makes no sense. So I tried totally different gifs (just a pair of yellow blinking eyes to replace gif_standby) and compiling fails with an error regarding the gif ...dunno if its down to size or something. I gave up after that.
Im getting very frustrated with it lol.

borysne, 2024-07-23:
I haven’t been able to do anything for 3 weeks now!) This is very strange! It seems to me that we are not reflashing anything at all, but simply restoring the device! because when the device is flashed, it must reset the memory of the wifi settings! but this doesn’t happen to me! the device remembers its ip and login!

borysne, 2024-07-23:
I think when I reflash there should be a white screen as the default!

borysne, 2024-07-23:
I've already tried everything! the only last option that I haven’t done is to try to compile the firmware via Arduino and flash it

borysne, 2024-07-23:
I still don’t understand! You managed to compile the firmware via platformIO! and flash it via flash_tool?

spigrex, 2024-07-23:
Did you try it with all three files included? (Bootloader, partitions and firmware) clearly something isn't quite right still as the gifs just don't seem to change (though the knomi will at least start). If I use any other gifs (same size etc) I just get an error when compiling. Though I'm hoping that's something I can figure out later

borysne, 2024-07-23:
Of course I tried 3 files! I tried my own firmware, I tried other ready-made firmwares! everything doesn't work as soon as I build the firmware via platformIO! Only the original bin from the knomi website works for me and the user's bin file https://github.com/JonathanBourassa/Unofficial-ZeroG-KNOMI works.
and if I zeroG build the firmware myself it doesn’t work again(((

spigrex, 2024-07-26:
OK. Problem solved using information from another ticket ...it was embarrassingly simple hahaha

In platformio.ini towards the bottom, change platform to the below -
platform = espressif32@6.4.0

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

Hope this works for you!

borysne, 2024-07-26:
does it work for you?
Did you manage to create a custom theme and flash it via OTA?

borysne, 2024-07-26:
I got desperate today and have already started collecting stealthburner! It will be bad if I can’t flash the firmware! no access to usb!)))

spigrex, 2024-07-26:
Yes just tried ota and that works as well. Have tried a custom gif which has worked (just changed the standby to yellow lol)

spigrex, 2024-07-26:
The first reflash I did was using the download tool, but I don't think it will make a difference if you have it up and running on the pre compiled firmware

borysne, 2024-07-26:
ok! I'm taking a risk and will try now)))

spigrex, 2024-07-26:
Let us know how you get on!

borysne, 2024-07-26:
I just managed to assemble the standard firmware via platformIO and flash it via OTA!

borysne, 2024-07-26:
you are just a genius!!!
Thank you!)))

spigrex, 2024-07-26:
Aaahhh yeah, happy for you dude, drove me insane trying to fix it haha.
Can't take all the credit saw another issue that had the awnser, but it didn't actually say what to do with it haha.

borysne, 2024-07-26:
I hope this topic will help other users thanks to you!!!
Now I can try to create custom firmware!)))

borysne, 2024-07-26:
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

borysne, 2024-07-26:
Excellent!!! You genius!!!)))

Closed 2024-09-11.

Thread 80 (2024-09-11):

Knomi v2 vs Eddy Coil problem

borysne, 2024-09-11:
hi, I have a very rare compatibility problem
My equipment:
Voron 2.4 board Manta-M8P v2 + CB1, head Stealthburner with EBB 2240, Eddy Coil , Knomi v2
Eddy coil is connected to the i2c port on the MP8 v2 board
Knomi v2 is connected as usual via wi-fi
Eddy coil is configured, works fine, scans and levels the table!
"""The essence of the problem: i turn on the 3d printer, while the Klipper is loading, the Knomi v2 loses wi-fi, as soon as i turn off the power of the Eddy coil, the Knomi v2 starts working as it should!"""
I have already tried everything! I changed the Knomi v2 wifi antenna, connected separate 5v. tried different firmware Knomi v2.
I did a bunch of experiments! As soon as the Knomi v2 is inside the 3D printer, the Wi-Fi connection is immediately lost!
I suspect that the problem is in the large magnetic field!!!
it is also interesting that the CB1 board has no problems with wi-fi!
the CB1 board is under the table, maybe that's why!
Gentlemen, do you have any thoughts???

borysne, 2024-09-18:
klippy log were!
[klippy (1).log](https://github.com/user-attachments/files/17048378/klippy.1.log)

Thread 83 (2024-12-26):

Knomi wont connect to printer

snowzones, 2024-12-26:
I have connected the knomi to the same ip but when im trying to connect to the k1 max i am greeted with (printer is unoperational please check your printer) screen on the knomi

Have i missed a step or something do i need to root and install mainsail on the printer for it to work?

Thread 84 (2025-01-05):

KNOMI2 randomly showing "Logo stripes"

dmit2k, 2025-01-05:
Hello,

having strange issues with a new KNOMI2 device:

1) successfully set up and connected to the printer, but it randomly shows those animated stripes (Voron logo?) on the screen, both in standby and when working with menus.

First I thought than may be a connection problem, but then discovered that it has its own specific notification for WiFi connection issues

2) extremely poor WiFi stability, and attaching the supplied antenna changes absolutely nothing.

The Knomi is located a couple of meters from my WiFi point and other 2.4GHz devices are working flawlessly.

Any ideas or suggestions on either issue?

Thread 85 (2025-01-05):

Any mods for the "printing" screen with usable info?

dmit2k, 2025-01-05:
Are there any ways to somehow customise the info shown on the screen while printing?

Those accelerator bars are absolutely useless, I would prefer seeing the hotend / bed temperature, or ETA, or the part fan speed.

Are there any ready made mods or alternative firmwares available? For my surprise I could not find anything except some ugly animation forks.

Thread 87 (2025-05-07):

How do I use the OV2640?

cray12399, 2025-05-07:
I got a Knomi v2 but there is no information or guide on how to use the OV2640. How can I view the camera feed and how can I link it with Klipper?

bigtreetech, 2025-05-07:
The port was reserved for the potential of future use but this functionality has not been implemented.

cray12399, 2025-05-07:
Are there any plans to implement it? I kinda feel deceived since it's shown in your advertisements for the product, but doesn't actually function.

bigtreetech, 2025-05-07:
Not at the moment. Including these ports was done primarily to provide users with a platform to adapt the screen so that they can use it in their own DIY projects. We provide an I2C port as well as an OVS port for personal DIY exploration.

cray12399, 2025-05-07:
Makes sense. Where can I find the source code for the firmware so I can implement it myself?

Closed 2025-05-07.

Thread 91 (2025-07-20):

Request for KNOMI2 Firmware and Pinout Recovery Files

ZeroCool2017, 2025-07-20:
Hello BigTreeTech team,

I recently erased the firmware on my KNOMI2 screen while trying to update the firmware and am now unable to get any output on the display. Despite successful ESP32 uploads, the screen remains completely blank, and attempts to recover functionality using standard drivers (ILI9341, ST7789, GC9A01) have been unsuccessful.

Could you please provide:

The original firmware files or flash image for the KNOMI2,

The pinout or schematic for the display connections,

Or any resources to properly restore the display functionality?

I would appreciate any recovery materials or guidance you can provide so I can continue using my KNOMI2 with my printer setup.

Thank you for your time and support.

Best regards,
Lindsey

Escrich, 2025-09-05:
are you able to display in your computer the internal knomi web server?

Thread 92 (2025-09-05):

Nozzle temperature not showing right value

Escrich, 2025-09-05:
The nozzle temperature is not being shown, appearing always as zero, the value looks always as zero, but despite of this the value is controllable from knomi, if you set a temperature the machine shows it and start to heat, but knomi continues showing zero, all preheating or cooling functions are still working, the only problem is to display both values, current and setpoint,

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
