bigtreetech/KNOMI/KNOMI2/Hardware/BIGTREETECH Knomi V2.0-SCH.pdf

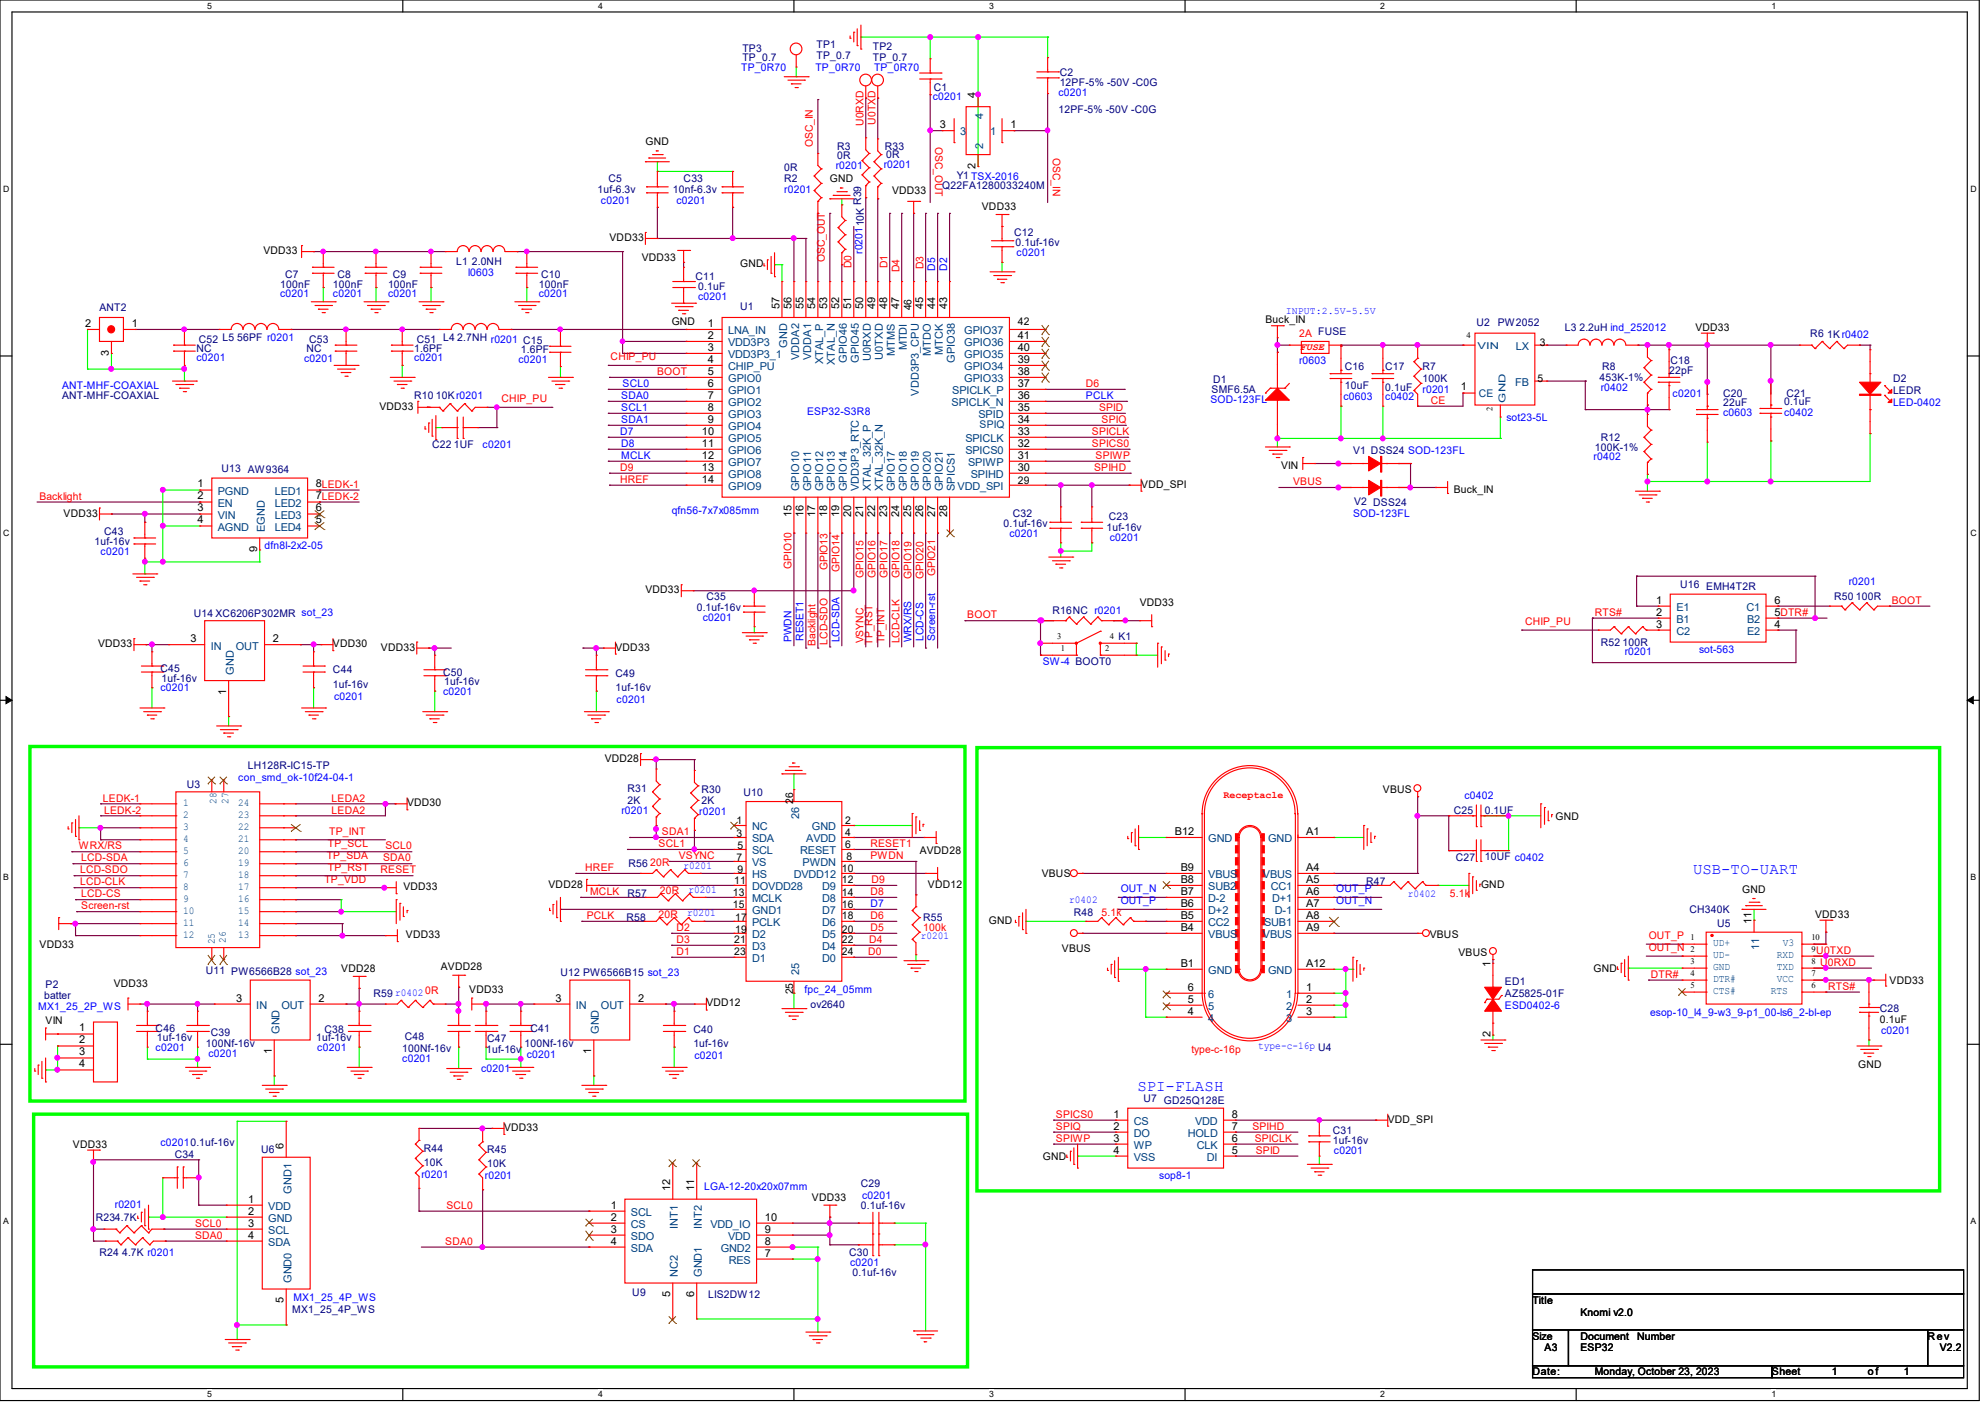
[picture p43: page 1]
