bigtreetech/KNOMI/KNOMI2/Hardware/BIGTREETECH knomi v2.0-TOP.pdf

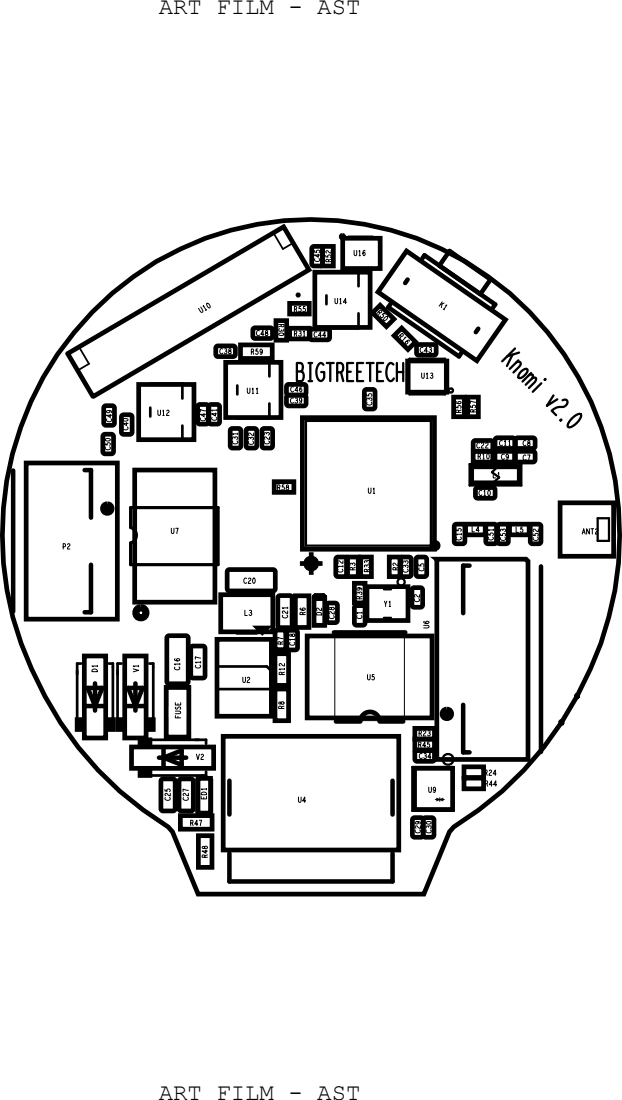
[picture p44: page 1]

ART FILM - AST
