bigtreetech/KNOMI/KNOMI1/Hardware/BIGTREETECH KNOMI v1.0-SIZE.pdf

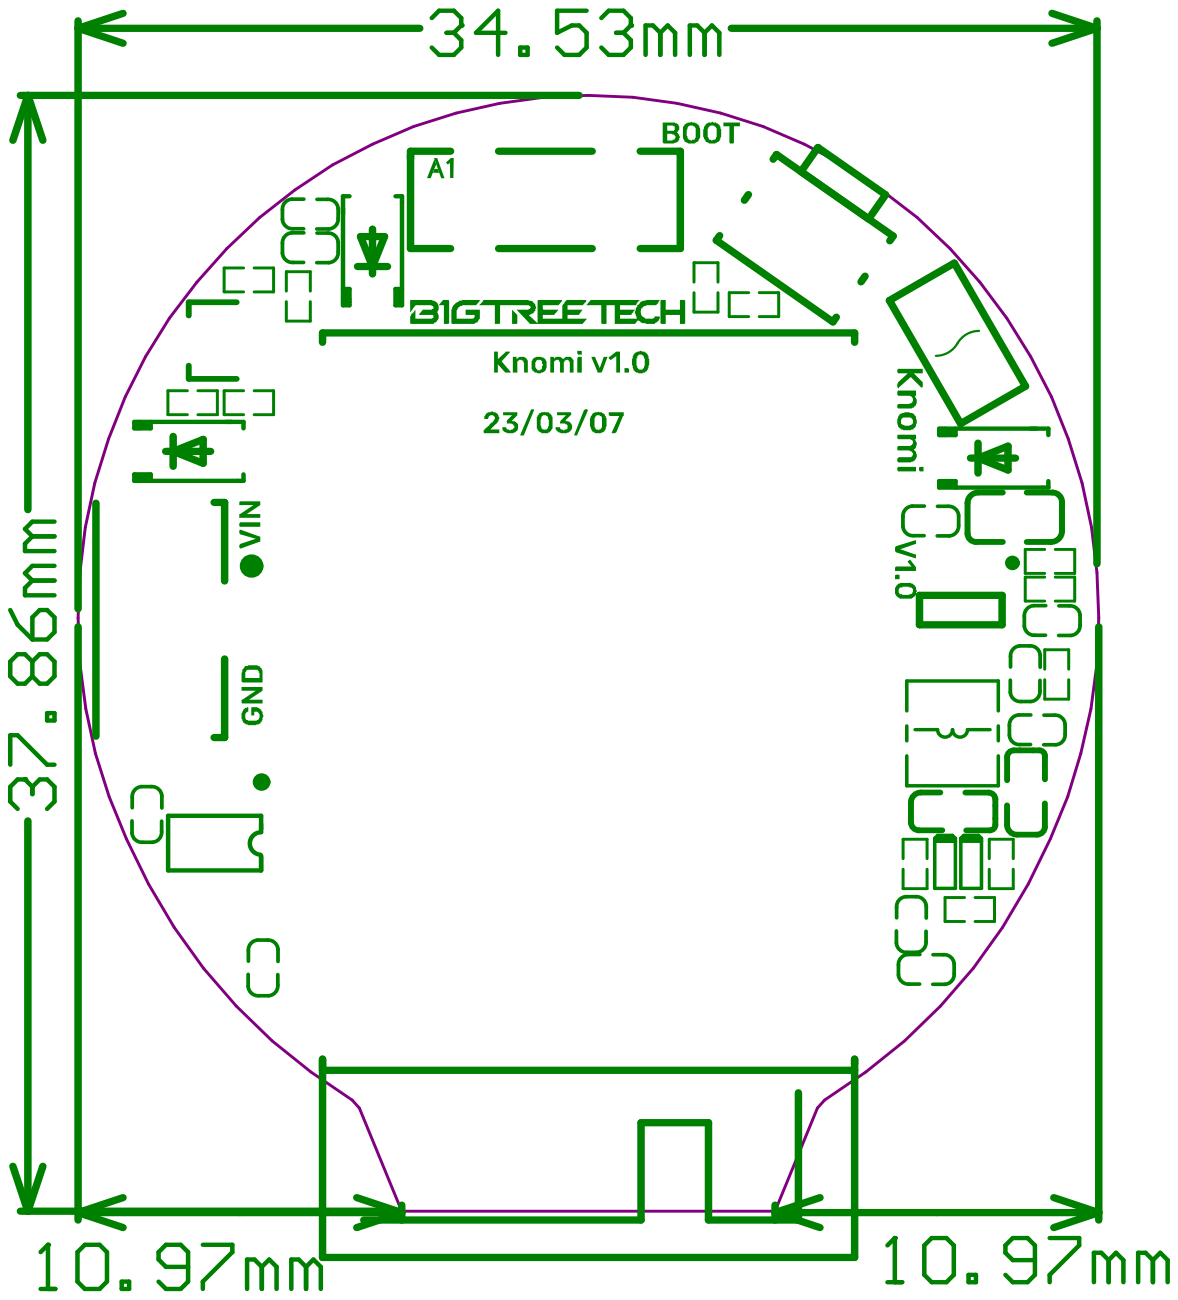
[picture p45: page 1]
