bigtreetech/KNOMI/KNOMI1/Hardware/BIGTREETECH KNOMI v1.0_topl.pdf

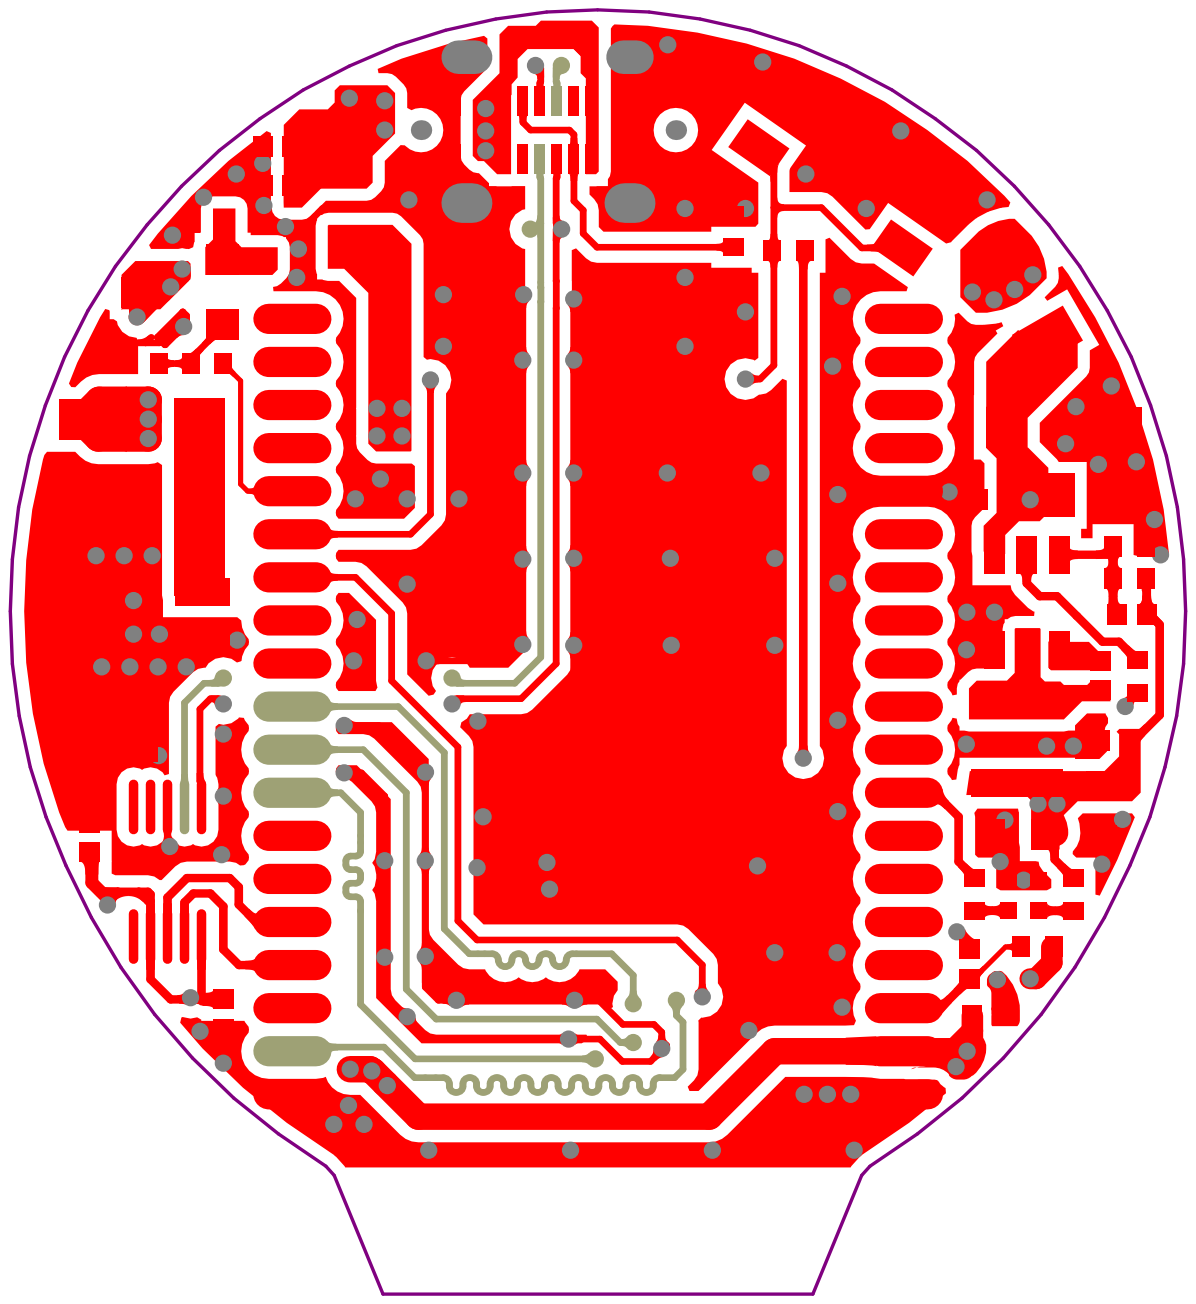
[picture p46: page 1]
