bigtreetech/KNOMI/KNOMI1/Hardware/BIGTREETECH KNOMI v1.0-bot.pdf

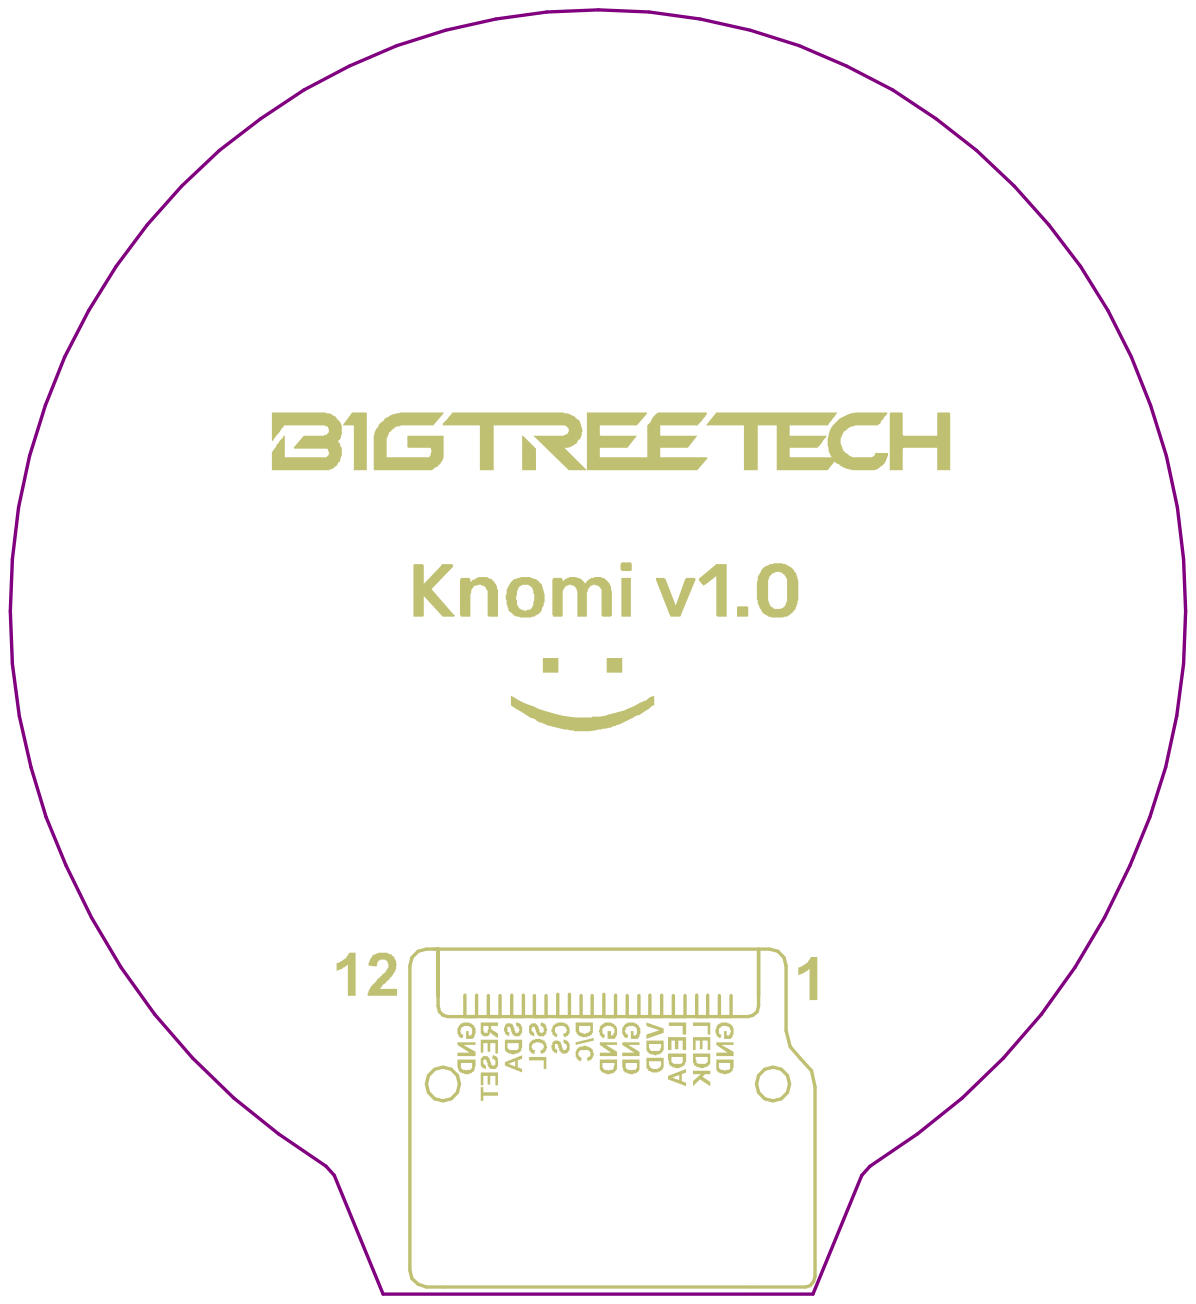
[picture p47: page 1]
