bigtreetech/KNOMI/KNOMI1/Hardware/BIGTREETECH KNOMI v1.0-botl.pdf

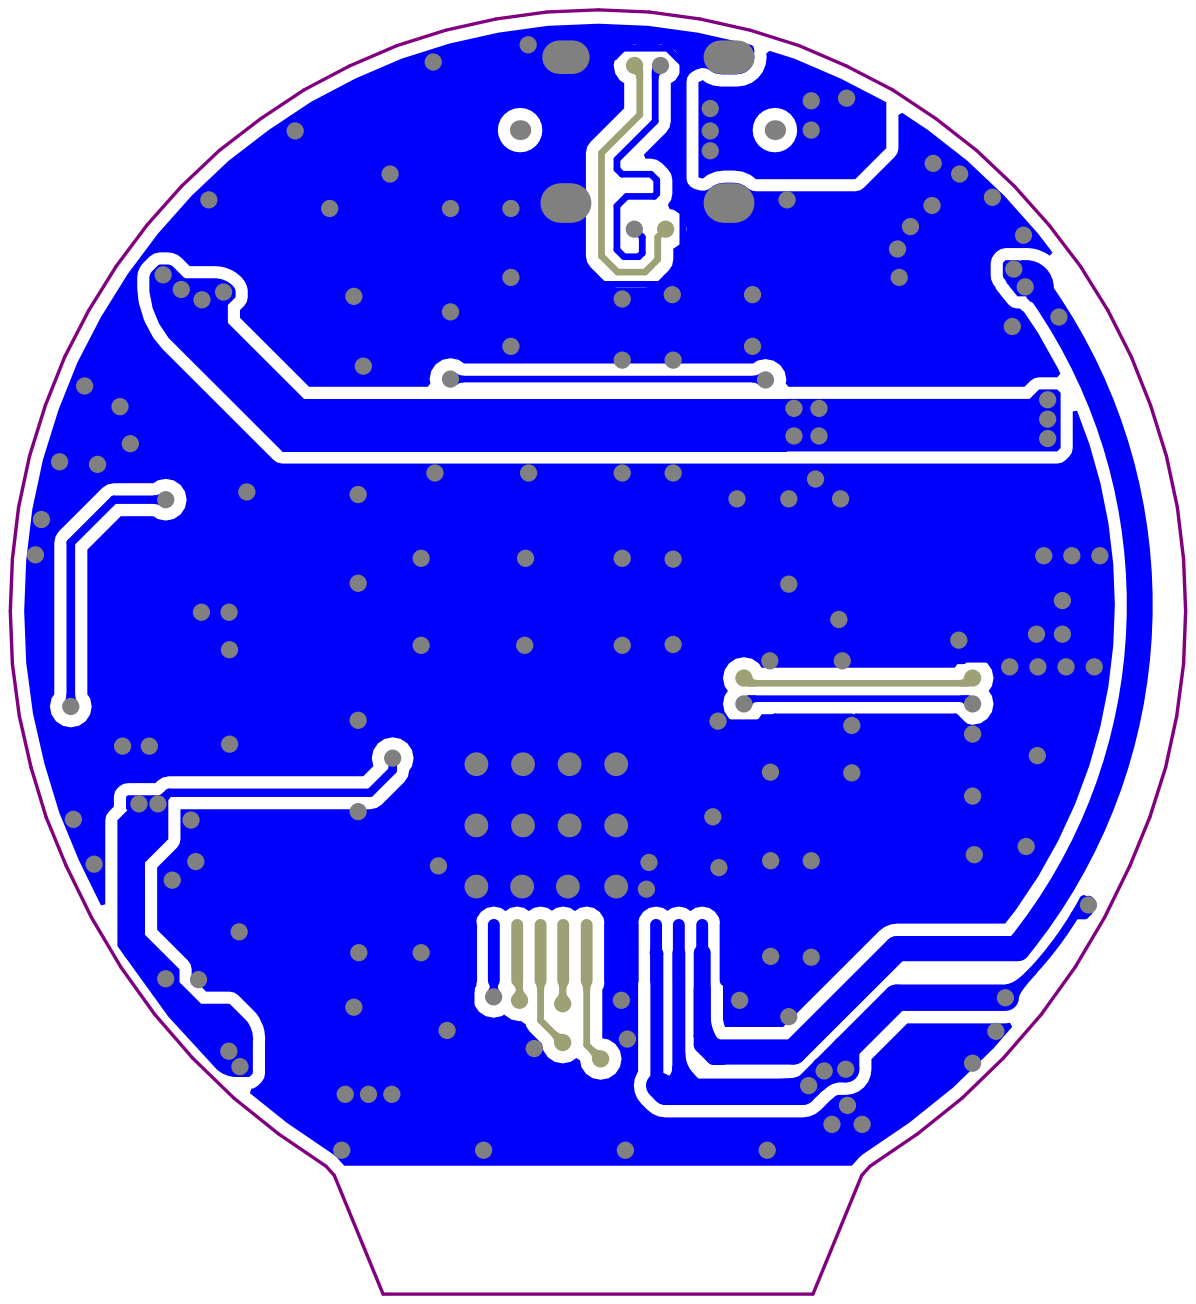
[picture p48: page 1]
