bigtreetech/KNOMI/KNOMI1/Hardware/BIGTREETECH KNOMI v1.0-SCH.pdf

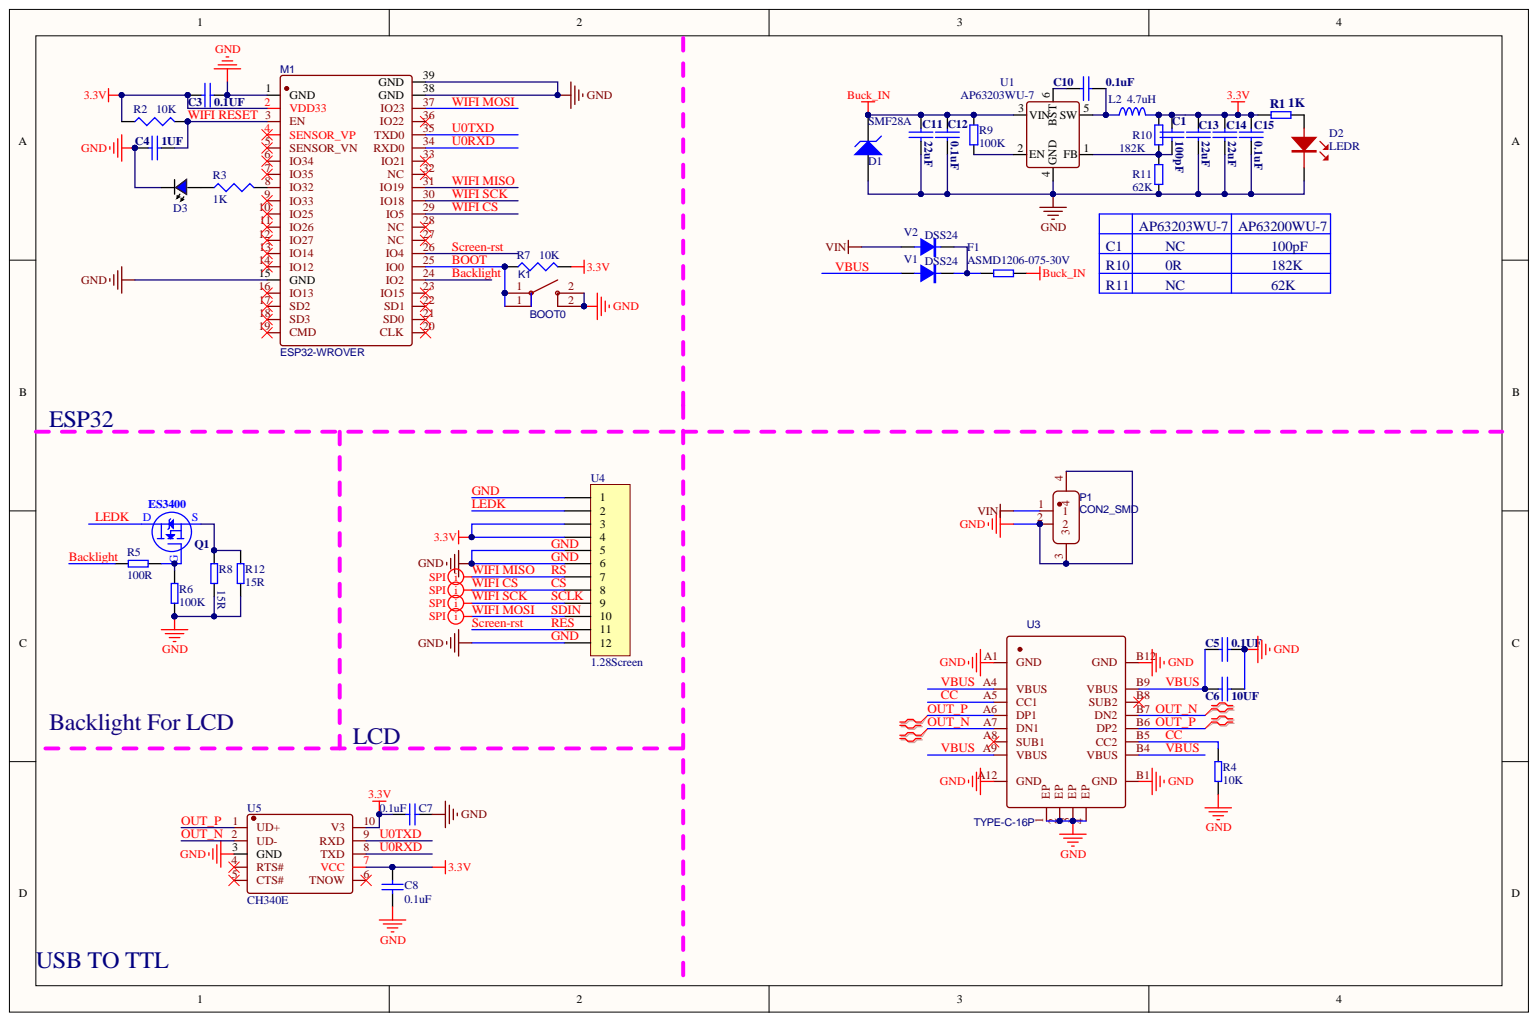
[picture p49: page 1]

AP63203WU-7 | AP63200WU-7
C1 | NC | 100pF
R10 | 0R | 182K
R11 | NC | 62K
