bigtreetech/KNOMI/(commit log)

2023-05-05 fix stl
2023-05-22 update stl
2023-06-05 Corrected stl for printed parts. (#12)
    * Delete Mounting Plate & StealthBurner Main Body for KNOMI.STL
    bugged file
    * corrected STL
    Files from https://github.com/thisiskeithb provided here : https://github.com/bigtreetech/KNOMI/issues/9#issuecomment-1559231846
    [StealthBurner Main Body for KNOMI.STL, StealthBurner Mounting Plate for KNOMI.STL]
2023-11-15 add KNOMI2
    [KNOMI 2 Mounting Plate固定卡环.stl, StealthBurner Main Body for KNOMI.STL, StealthBurner Mounting Plate for KNOMI.STL, partition.csv]
2023-11-15 klipper config
    [KNOMI.cfg]
2023-11-22 update stls
    [KNOMI 2 StealthBurner Main Body前罩.STL]
2023-12-06 update firmware
    [partition.csv]
2024-01-09 update main-body stl & manual
    [KNOMI 2 StealthBurner Main Body前罩.STL]
2024-03-30 Add KNOMI 2 mounting plate V2.0 STL &STEP (#66)
    [KNOMI 2 Mounting Plate固定卡环V2.0.STEP, KNOMI 2 Mounting Plate固定卡环V2.0.stl]
2024-06-26 add {rawparams} in bed_mesh_calibrate and qgl/z_tilt
    [KNOMI.cfg]
